MaksymKutyshenko/esp32-gps-tracker/hardware/assembly-sheet.html

# GPS Tracker Wiring

ESP32-S3 SuperMini build · rev 2 · 2026-10-15 · pins match firmware/include/config.hpp

Bench sheet for assembling the tracker on a breadboard. One table per module, read left to right: module pin, wire, where it goes. Wire colours follow the legend so a photo of the board can be checked against this page.

Before the first wire

- 3.3 V logic everywhere. The ESP32-S3 pins are not 5 V tolerant. GNSS modules and the OLED output 3.3 V logic even when fed 5 V, so TX/RX/SDA/SCL go straight in.
- Measure the shield's "3V" rail first. Listings disagree whether it is 3.0 V or 3.3 V. Below 3.1 V, feed the OLED and BMA400 from the board's 3V3 pin instead and give the SD module 5 V (level-shifter type only).
- Never join the SuperMini's 3V3 pin to the shield's 3V rail. Both are regulator outputs. The board makes its own 3.3 V from its 5V pin.
- The SuperMini's 5V pin is its USB power line, with no diode. Feed it from the shield only with the USB cable unplugged. On the bench with the console open, power the board from USB and leave that wire off; keep GND common.
- BIGGA GSM: TX is 5 V logic and the modem draws 2 A bursts. Put 6.8 kΩ from the board's TX pin to GND before it reaches GPIO44. Put C1, a 1000 µF electrolytic, across VSS and GND right at the board's pins, + to VSS: the board's own 100 + 10 + 1 µF are not enough on battery, and without C1 every registration burst resets the ESP32. Use short 22 AWG or thicker wires for VCC/GND.
- PWRKEY through an NPN transistor. Q1 2N2222A at the ESP end: GPIO7 → 10 kΩ → base, 100 kΩ base to GND, emitter to GND, collector to PK. A bare wire from the modem's PK pin carried the disturbance of every network attach into the chip and reset it with the task watchdog. Find the transistor's pins with the meter's diode test first. Without a transistor: 1 kΩ in series with 100 nF to GND and gsmPowerKeyViaTransistor = false, or PK tied to GND and gsmPowerKeyWired = false.
- One ground. Every GND goes to the shield's GND. Star it at the shield, not daisy-chained through modules.
- Check 18650 polarity twice before inserting. A reversed cell burns the shield's protection IC.
- Antennas. GNSS patch antenna face-up with a sky view; keep the GSM antenna cable away from it.

## Rails and wire colours

Four rails come off the battery shield. Everything in the tables below is tagged with one of them or with a signal name.

+5V red +3V3 orange GND black B+ (cell) purple signals: TX yellow · RX green · SDA blue · SCL white · SPI grey · control brown

flowchart LR
  CELLS["2 x 18650 HG2"] --> SHIELD["Battery Shield V8
boost + protection"]
  SHIELD -- "+5V ≤ 2.2 A, USB unplugged" --> DEV["SuperMini 5V pin
(onboard LDO → 3V3_BOARD)"]
  SHIELD -- "+5V" --> GNSS["GNSS module VCC"]
  SHIELD -- "+5V, short thick wires" --> GSM["BIGGA GSM VCC"]
  SHIELD -- "+3V3 1 A" --> OLED["SSD1306 VCC"]
  SHIELD -- "+5V" --> SD["MicroSD adapter VCC
(onboard 3.3 V regulator + shifter)"]
  SHIELD -- "+3V3" --> ACC["BMA400 VCC, button module VCC"]
  SHIELD -- "B+ (cell)" --> DIV["100k / 100k divider → GPIO1"]
  SHIELD -- "GND star" --> ALL["every module GND"]

## Wiring diagram

Every wire on the bench, drawn once. Each module's subtitle names the bus it talks on (UART, I2C, SPI, ADC, interrupt) with its speed or address, and the tags inside the board mark which peripheral each pin group belongs to. The board's pins are in logical order here (grouped by module), not in header order; the pin map below gives the physical positions. Power rails run down both sides from the shield.

## ESP32-S3 SuperMini pin map

The SuperMini is the hub. Every signal wire ends here; the table is the same assignment as config.hpp and the schematic.

Board pin | Direction | Signal | Goes to
5V | ← | +5V | Battery shield 5V, only with USB unplugged (the pin is USB VBUS)
GND | — | GND | Battery shield GND (star)
3V3 | out | 3V3_BOARD | Leave free. Do not tie to the shield rail.
GPIO1 | ← | BATT_SENSE | Divider midpoint (R1/R2)
GPIO2 | ← | BTN | Button module SIG (the module has its own pull-down)
GPIO5 | ← | GNSS_TXD | GNSS TX
GPIO4 | → | GNSS_RXD | GNSS RX
GPIO6 | ← | ACC_INT1 | BMA400 INT1
GPIO7 | → | GSM_PWRKEY | R5 10 kΩ to Q1's base (R6 100 kΩ base to GND); Q1's collector to BIGGA PK. High = key pressed
GPIO8 | ↔ | SDA | OLED SDA, BMA400 SDA, GNSS compass SDA
GPIO9 | → | SCL | OLED SCL, BMA400 SCL, GNSS compass SCL
GPIO10 | → | SD_CS | MicroSD CS
GPIO11 | → | SD_SCK | MicroSD SCK (CLK)
GPIO12 | → | SD_MOSI | MicroSD MOSI (DI)
GPIO13 | ← | SD_MISO | MicroSD MISO (DO)
GPIO43 (TX) | → | GSM_RXD | BIGGA RX
GPIO44 (RX) | ← | GSM_TXD | BIGGA TX, with 6.8 kΩ from that pin to GND
USB-C port | — | console | Laptop, USB Serial/JTAG: log + commands, flashing

Keep off: GPIO0 (BOOT), GPIO3, GPIO19/20 (USB), GPIO45/46. The onboard RGB LED on GPIO48 is the status light; nothing to wire. DevKitC-1 build (pio run -e devkitc): the same pins, except the modem on GPIO17/18 and the console on the "UART" connector.

## Module by module

### Battery Shield V8 with 2×18650

J5 · source of every rail

Cells in parallel. Charge through the shield's own USB port. Expect a 0.5 s dropout when the charger is plugged in; the firmware keeps state in NVS so that is harmless.

Shield pin | | Rail | Feeds
5V | → | +5V | SuperMini 5V (USB unplugged), GNSS VCC, BIGGA GSM VSS, MicroSD VCC
3V | → | +3V3 | OLED VCC, BMA400 VCC and CS, button module VCC. Measure first.
GND | — | GND | Star point for every module, the board, capacitors −, divider, button module
B+ (cell terminal) | → | +BATT | R1 top only (battery divider)

### GNSS: Foxeer M10Q-250 (or Beitian BE-220)

J1 · UART1

Foxeer has six pads; the BE-220 only the first four. TX and RX cross: the module's TX goes to the ESP's RX pin. Baud: Foxeer 115200 (default profile), BE-220 9600 (set gnss 1, save).

Module pin | | Net | Connect to
VCC / 5V | ← | +5V | Shield 5V
GND | — | GND | Shield GND
TX | → | GNSS_TXD | SuperMini GPIO5
RX | ← | GNSS_RXD | SuperMini GPIO4
SCL (Foxeer compass) | ← | SCL | SuperMini GPIO9 (optional)
SDA (Foxeer compass) | ↔ | SDA | SuperMini GPIO8 (optional)

### SSD1306 0.96" OLED

J3 · I2C 0x3C

The module carries its own pull-ups. Bus runs at 100 kHz, so breadboard wires are fine.

Module pin | | Net | Connect to
GND | — | GND | Shield GND
VCC | ← | +3V3 | Shield 3V (or the board's 3V3 if the rail measures 3.0 V)
SCL | ← | SCL | SuperMini GPIO9
SDA | ↔ | SDA | SuperMini GPIO8

### MicroSD SPI module

J4 · SPI2

Pins run in a straight row on the board: CS 10, SCK 11, MOSI 12, MISO 13. This adapter (6 pins, rated 4.5–5.5 V) is the 5 V kind: it has its own 3.3 V regulator and a level-shifter chip, so VCC goes to a shield 5V pin and the four signals go directly to the board at 3.3 V. On 3.3 V it stays silent and the firmware reports a mount timeout. Card: 8–32 GB, FAT32.

Module pin | | Net | Connect to
GND | — | GND | Shield GND
VCC | ← | +5V | Shield 5V (module regulates to 3.3 V internally)
MISO (DO) | → | SD_MISO | SuperMini GPIO13
MOSI (DI) | ← | SD_MOSI | SuperMini GPIO12
SCK (CLK) | ← | SD_SCK | SuperMini GPIO11
CS | ← | SD_CS | SuperMini GPIO10

### BIGGA GSM (SIM800C) board

J2 · UART2 · C1 1000 µF on VSS · R3 6.8 kΩ on TX · Q1 NPN on PK · LED1 + 1 kΩ on NET

Silkscreen names on the board: NET VSS PK RX TX GND on one edge, SPN SPP MICN MICP RING DTR on the other. VSS is the 5 V supply input here, not ground; confirm with the meter that the pin marked GND beeps against the SMA shell and VSS does not. TX idles at 5 V: the board's level shifter is referenced to VCC, so a 6.8 kΩ resistor from TX to GND is required before GPIO44 (gives about 3.0 V). RX needs nothing extra. BOOT is the modem's PWRKEY; the board does not start by itself, the firmware holds BOOT low for a second when the modem is silent, through the transistor Q1 at the ESP end. Feed VCC with 5 V only: 9 V damages the ESP through the shifter, 3.3 V is below the regulator's dropout. Nano-SIM, PIN disabled, 2G coverage confirmed, full-size SMA antenna.

Board pin | | Net | Connect to
GND | — | GND | Shield GND, short thick wire
TX | → | GSM_TXD | R3 6.8 kΩ from this pin to GND, then the pin to SuperMini GPIO44
RX | ← | GSM_RXD | SuperMini GPIO43 directly
PK (= BOOT / PWRKEY) | ← | GSM_PWRKEY | Q1 collector; Q1 emitter to GND, base through R5 10 kΩ to SuperMini GPIO7, R6 100 kΩ base to GND
VSS (= VCC, 5 V in) | ← | +5V | Shield 5V, short thick wire, and C1 1000 µF electrolytic across VSS and GND right at the board's pins (+ to VSS); the onboard 100+10+1 µF are not enough on battery
NET | → | LED1 | NET → 1 kΩ → red LED anode; LED cathode → GND. Blink: 0.8 s = searching, 3 s = registered, 0.3 s = GPRS data. 2.8 V signal, dim but visible; no GPIO
DTR, RING, SPN, SPP, MICN, MICP | — | n/c | Leave open
Antenna | — | SMA | GSM SMA antenna, cable routed away from the GNSS patch

### Button module

J7 · 3 pins

A module with VCC, GND and a signal pin. Its own pull-down holds SIG low at rest; a press connects it to VCC, so buttonPressedHigh = true in config.hpp. A bare switch to GND works too, with that setting false. Short press = next display page, hold ≥ 1 s = print diagnostics; also a deep-sleep wake source.

Module pin | | Connect to
VCC | ← | +3V3 shield 3V
GND | — | GND
SIG | → | SuperMini GPIO2 BTN

### Battery sense divider

R1, R2 · 100 kΩ each

Halves the cell voltage so 4.2 V becomes 2.1 V at the ADC. 100 k keeps the drain at about 20 µA.

Part | | Connect to
R1 end A | ← | +BATT shield B+
R1 end B + R2 end A | → | SuperMini GPIO1 BATT_SENSE
R2 end B | — | GND

### BMA400 (CJMCU-400)

J6 · I2C 0x14 · INT1 → GPIO6 · CS → 3V3

Shares the I2C bus with the OLED. INT1 lands on an RTC-capable pin: it wakes the chip from deep sleep. Tie CS to 3V3: the chip picks I2C or SPI from that pin at power-up, and left to the board's pull-up it came up in SPI mode on one boot in three, silent on the bus. SDO sets the address (low 0x14, high 0x15); the firmware probes both, so tying it to GND is optional but makes the boot log predictable. INT2 stays unconnected.

Module pin | | Net | Connect to
VCC | ← | +3V3 | Shield 3V (3.3 V only; never 5 V)
GND | — | GND | Shield GND
SDA | ↔ | SDA | SuperMini GPIO8
SCL | ← | SCL | SuperMini GPIO9
INT1 | → | ACC_INT1 | SuperMini GPIO6
CS | ← | +3V3 | Shield 3V, same rail as VCC (I2C mode at power-up)
SDO | ← | GND | Optional: fixes the address at 0x14
INT2 | — | n/c | Leave open

## Assembly order with checks

Add one module at a time and watch the console after each. The expected log line comes from the firmware; if it does not appear, stop and fix that module before adding the next. Ticks are remembered in this browser only.

1. Shield: insert cells (polarity!), switch on, measure 5V and 3V rails with the multimeter. Write the 3V figure here: ______ V.5V rail: 4.9–5.2 V · 3V rail: 3.0 or 3.3 V (decides OLED/SD supply)
2. SuperMini alone: USB-C to the laptop, GND to the shield, flash with pio run -e supermini -t upload -t monitor. If the port does not appear, hold BOOT while plugging in.I (..) tracker: Boot: reset reason power-on (1) I (..) console: Commands on USB Serial/JTAG; type 'help' LED white, then amber once the GNSS is added
3. Button module (VCC 3V3, GND, SIG→GPIO2) and the battery divider on GPIO1.a press logs "Button: short press, next page"; diag → battery error counter stays 0; the system page shows the cell voltage
4. GNSS: 5V, GND, TX→GPIO5, RX→GPIO4. Put the antenna by a window or outside.I (..) tracker: State BOOTING -> ACQUIRING I (..) tracker: State ACQUIRING -> TRACKING (sky view, 30–90 s cold) Wrong baud: 'rej' grows in diag → set gnss 1 / save
5. OLED: GND, VCC, SCL→GPIO9, SDA→GPIO8.I (..) ssd1306: Display ready at address 0x3C Tracking page with state, satellites, position
6. MicroSD: GND, VCC→shield 5V (not 3V), CS→GPIO10, SCK→GPIO11, MOSI→GPIO12, MISO→GPIO13 (a straight run). Card formatted FAT32.I (..) sdcard: Mounted /sdcard: NNNN MiB 'SD ok' on the screen; TRACKS/YYYYMMDD.CSV appears after the first record
7. BIGGA GSM: 6.8 kΩ from TX to GND, LED + 1 kΩ on NET, C1 1000 µF across VSS/GND at the board (+ to VSS), Q1 with R5 10 kΩ and R6 100 kΩ for PK at the ESP end, then VCC/GND with short thick wires, TX→GPIO44, RX→GPIO43, PK→Q1 collector (base via R5 from GPIO7), VSS→5V (it is the supply, not ground), antenna. Measure TX idle at GPIO44 with the modem on: expect about 3.0 V, not 5 V. NET LED: fast blink while searching, one blink every 3 s once registered. Console: set apn <your apn>, set url ..., set id ..., set uplink 1, save.I (..) sim800: Modem silent at every baud rate, pulsing PWRKEY (1/3) (normal: the board needs the pulse) I (..) sim800: Modem answered at 9600 baud (or 115200) I (..) uplink: GPRS up on APN internet 'sent:' grows on the system page; the point appears in Traccar
8. Soak: leave it running 10 minutes, then diag. Note the counters and stack headroom for the README.nmea rx N rej 0 silences 0 | log ok N drop 0 err 0 | up ok N ... | stack free: gps … display … logger … uplink … ui …

Sources in the repository: hardware/README.md (power tree, GPIO map), hardware/kicad/gps_tracker.kicad_sch (schematic, ERC clean), firmware/include/config.hpp (the pin constants the firmware uses). Module pin orders on the breakout boards vary by vendor; the tables name pins by function, so follow the silkscreen.
