MaksymKutyshenko/esp32-gps-tracker/hardware/kicad/gps_tracker.pdf

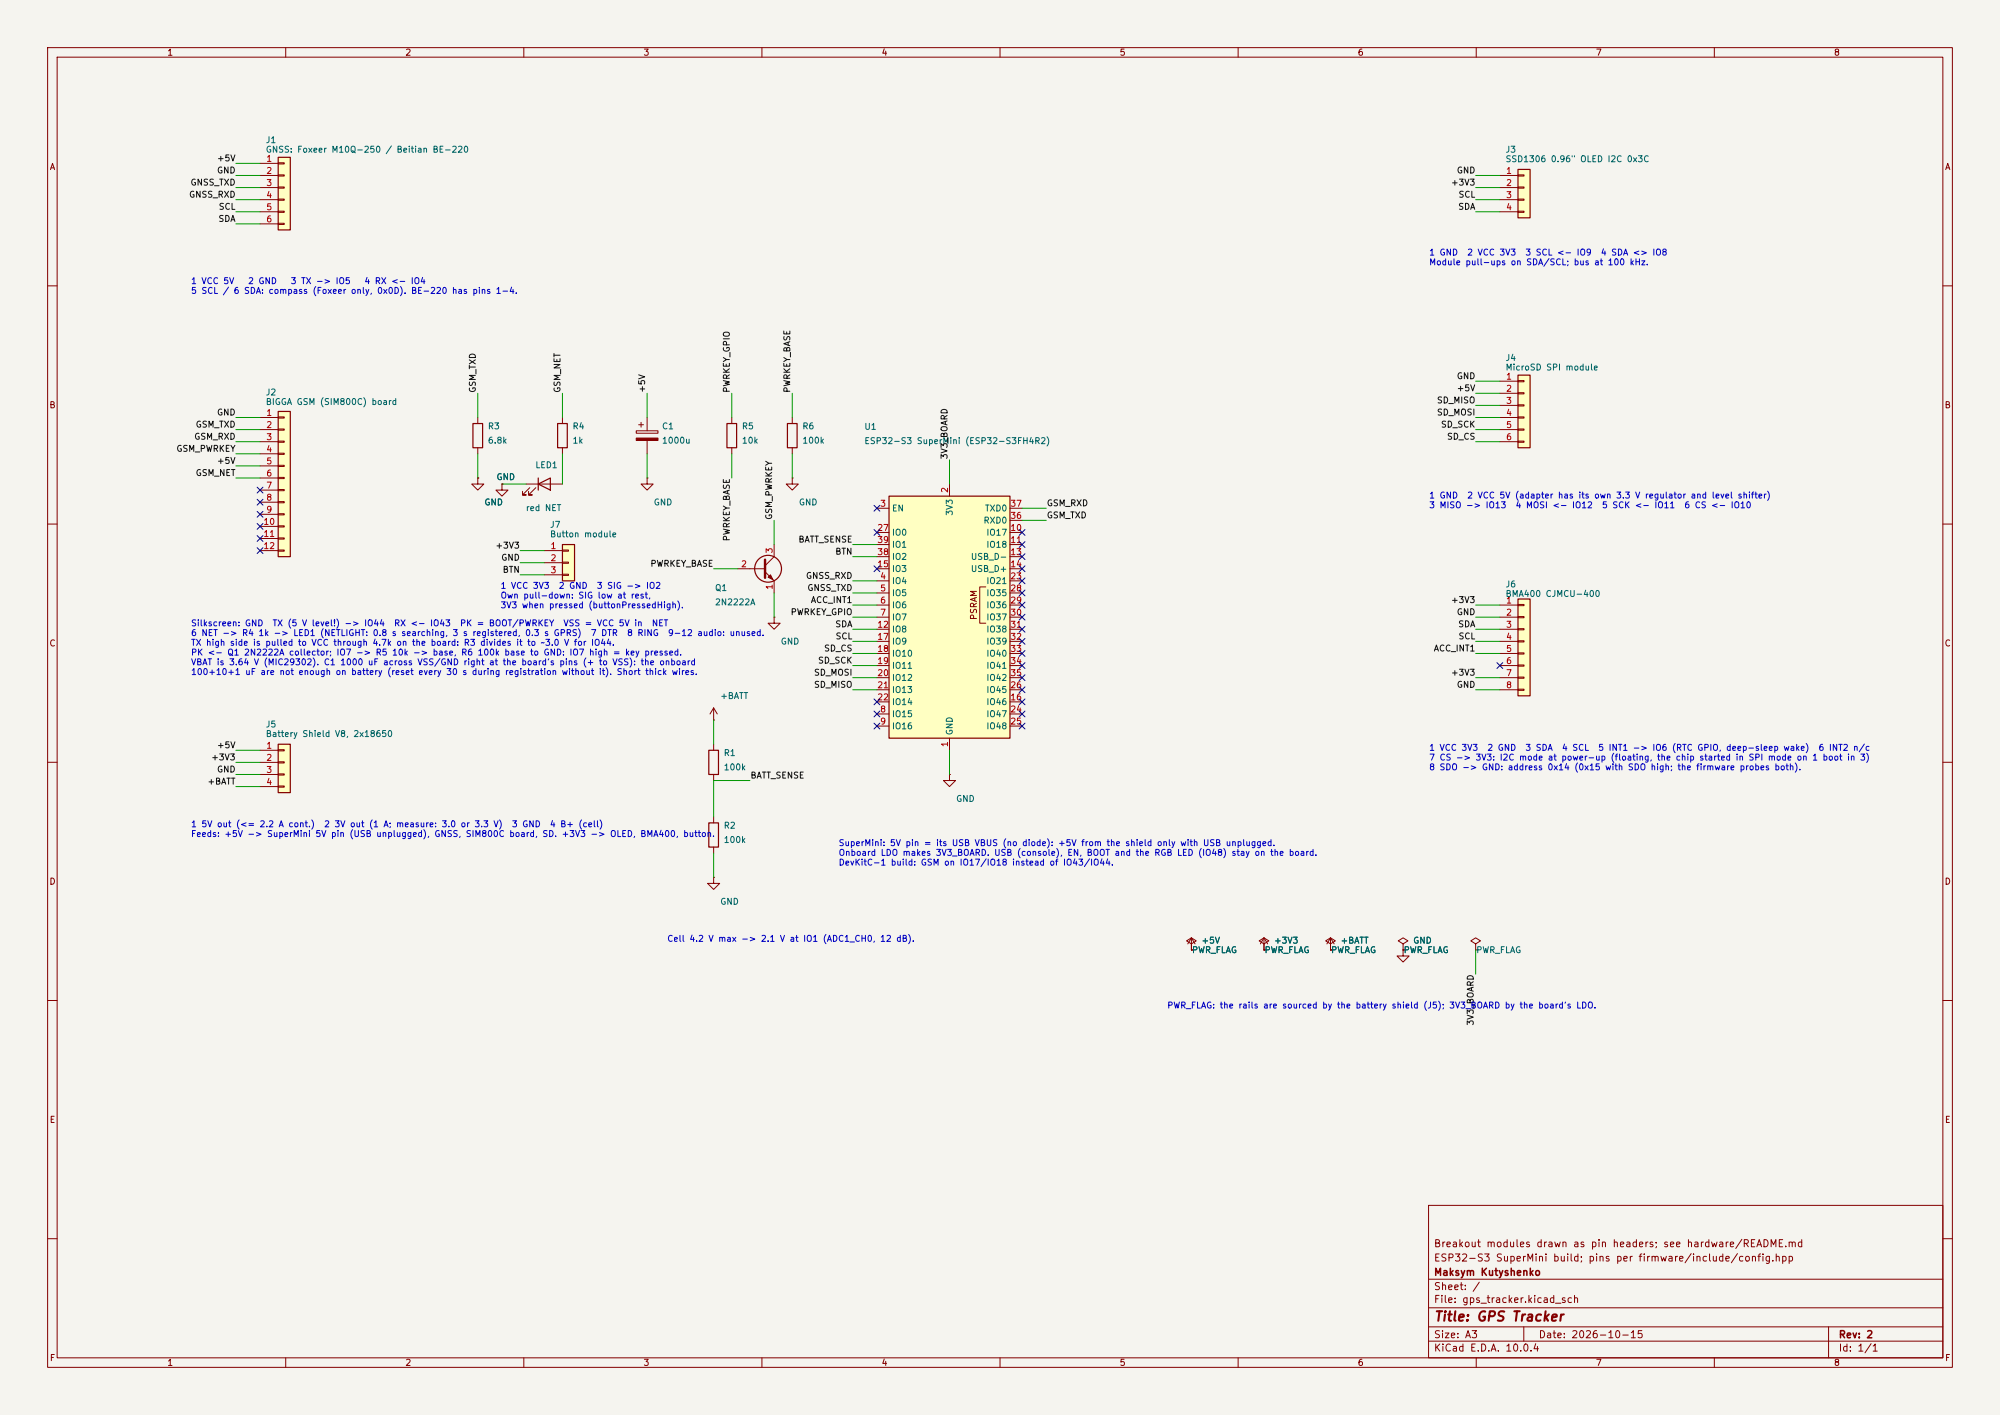
[picture p1: page 1]

5 SCL / 6 SDA: compass (Foxeer only, 0x0D). BE-220 has pins 1-4.

Silkscreen: GND TX (5 V level!) -> IO44 RX <- IO43 PK = BOOT/PWRKEY VSS = VCC 5V in NET 6 NET -> R4 1k -> LED1 (NETLIGHT: 0.8 s searching, 3 s registered, 0.3 s GPRS) 7 DTR 8 RING 9-12 audio: unused. TX high side is pulled to VCC through 4.7k on the board: R3 divides it to ~3.0 V for IO44. PK <- Q1 2N2222A collector; IO7 -> R5 10k -> base, R6 100k base to GND: IO7 high = key pressed. VBAT is 3.64 V (MIC29302). C1 1000 uF across VSS/GND right at the board's pins (+ to VSS): the onboard 100+10+1 uF are not enough on battery (reset every 30 s during registration without it). Short thick wires. Cell 4.2 V max -> 2.1 V at IO1 (ADC1_CH0, 12 dB).

Breakout modules drawn as pin headers; see hardware/README.md
ESP32-S3 SuperMini build; pins per firmware/include/config.hpp
Maksym Kutyshenko
Sheet: /
File: gps_tracker.kicad_sch
Title: GPS Tracker

Size: A3 | Rev: 2 | F Date: 2026-10-15
KiCad E.D.A. 10.0.4 | Id: 1/1
