MaksymKutyshenko/esp32-gps-tracker/docs/kicad/gps_tracker.pdf

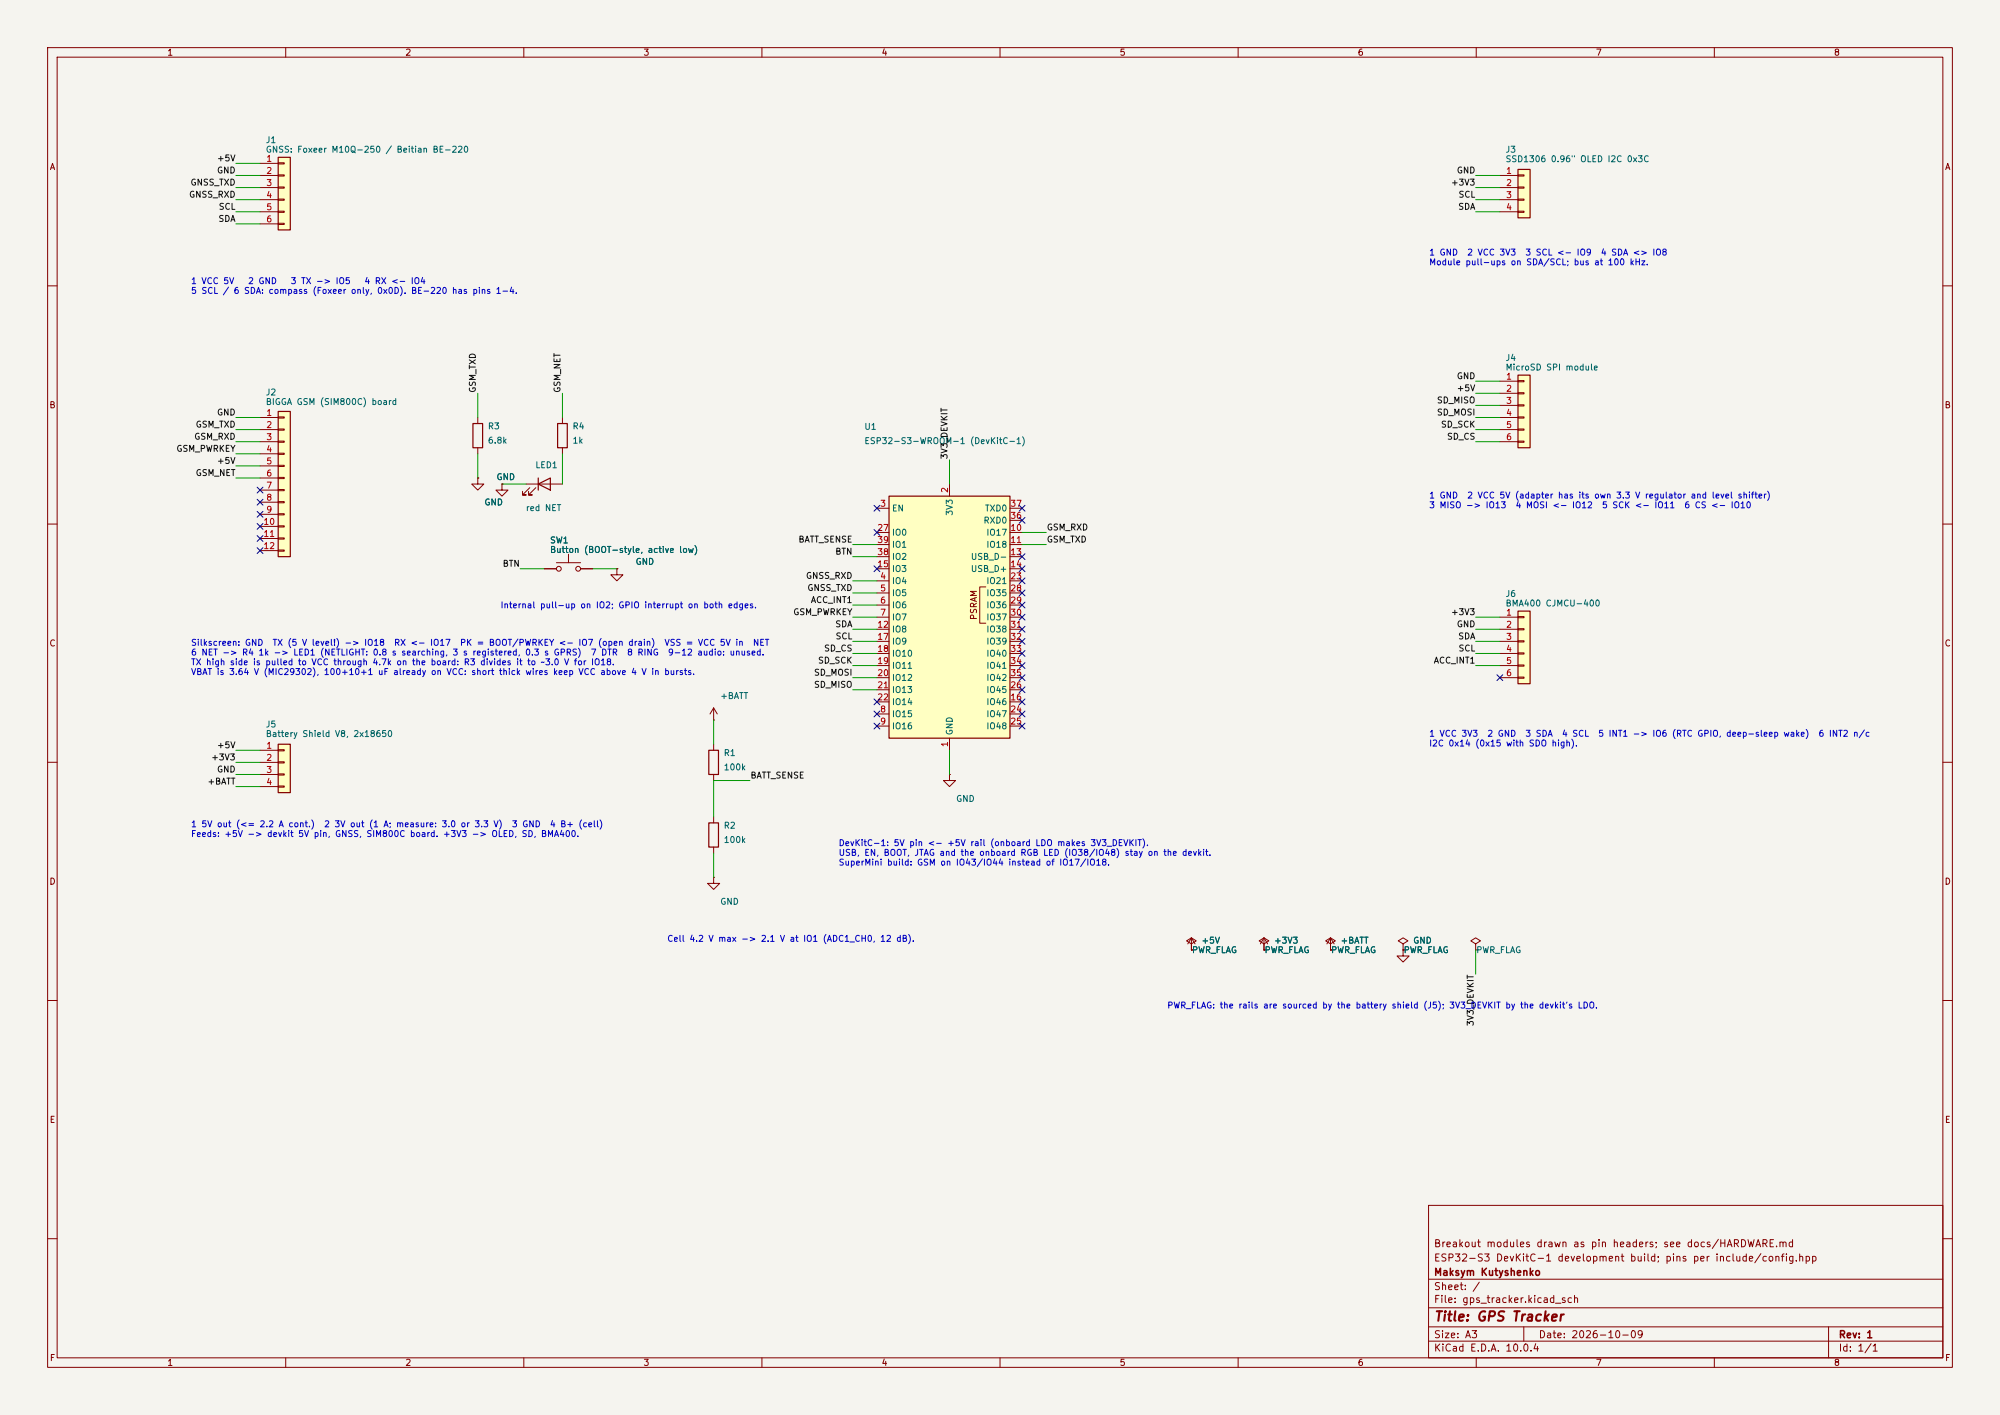
[picture p2: page 1]

5 SCL / 6 SDA: compass (Foxeer only, 0x0D). BE-220 has pins 1-4. Silkscreen: GND TX (5 V level!) -> IO18 RX <- IO17 PK = BOOT/PWRKEY <- IO7 (open drain) VSS = VCC 5V in NET 6 NET -> R4 1k -> LED1 (NETLIGHT: 0.8 s searching, 3 s registered, 0.3 s GPRS) 7 DTR 8 RING 9-12 audio: unused. TX high side is pulled to VCC through 4.7k on the board: R3 divides it to ~3.0 V for IO18. VBAT is 3.64 V (MIC29302), 100+10+1 uF already on VCC: short thick wires keep VCC above 4 V in bursts.

SW1 Button (BOOT-style, active low) GND

Breakout modules drawn as pin headers; see docs/HARDWARE.md PSRAM GND

PWR_FLAG: the rails are sourced by the battery shield (J5); 3V3_DEVKIT by the devkit's LDO.

ESP32-S3 DevKitC-1 development build; pins per include/config.hpp
Maksym Kutyshenko
Sheet: /
File: gps_tracker.kicad_sch
Title: GPS Tracker

Size: A3 | Rev: 1
KiCad E.D.A. 10.0.4 | Id: 1/1 | F Date: 2026-10-09
