MaksymKutyshenko/esp32-gps-tracker/hardware/kicad/gps_tracker.kicad_sch

## KiCad design hardware/kicad/gps_tracker.kicad_sch (2026-10-15)

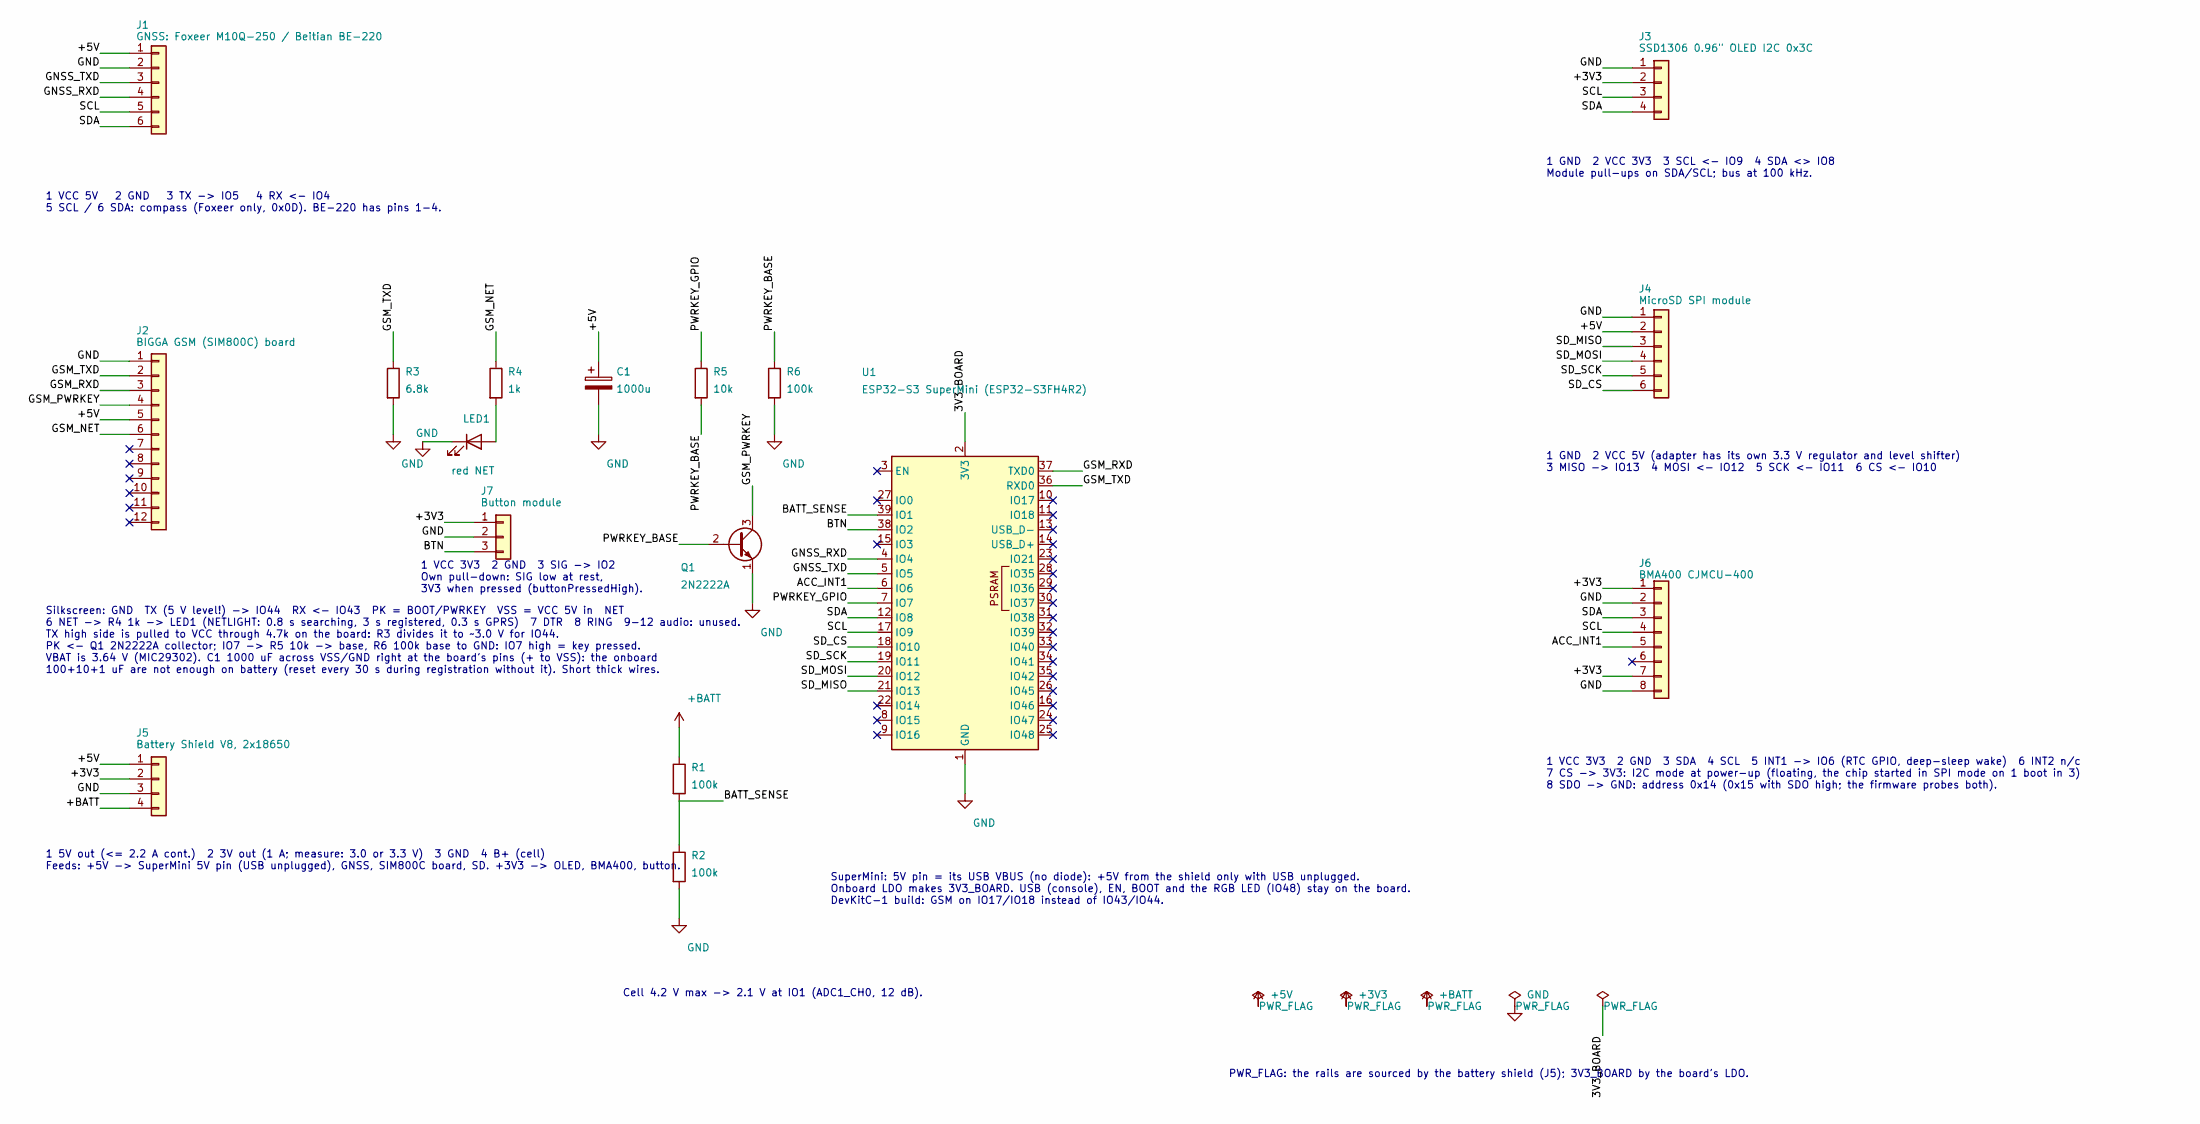
[picture p3: schematic gps_tracker.kicad_sch]

Parts:
C1: 1000u
J1: GNSS: Foxeer M10Q-250 / Beitian BE-220
J2: BIGGA GSM (SIM800C) board
J3: SSD1306 0.96" OLED I2C 0x3C
J4: MicroSD SPI module
J5: Battery Shield V8, 2x18650
J6: BMA400 CJMCU-400
J7: Button module
LED1: red NET
Q1: 2N2222A
R1, R2, R6: 100k
R3: 6.8k
R4: 1k
R5: 10k
U1: ESP32-S3 SuperMini (ESP32-S3FH4R2)

Connections:
3V3_BOARD: U1.2 (3V3)
+3V3: J3.2, J5.2, J6.1, J6.7, J7.1
+5V: C1.1, J1.1, J2.5, J4.2, J5.1
+BATT: J5.4, R1.1
ACC_INT1: J6.5, U1.6 (IO6)
BATT_SENSE: R1.2, R2.1, U1.39 (IO1)
BTN: J7.3, U1.38 (IO2)
GND: C1.2, J1.2, J2.1, J3.1, J4.1, J5.3, J6.2, J6.8, J7.2, LED1.1 (K), Q1.1 (E), R2.2, R3.2, R6.2, U1.1 (GND), U1.40 (GND), U1.41 (GND)
GNSS_RXD: J1.4, U1.4 (IO4)
GNSS_TXD: J1.3, U1.5 (IO5)
GSM_NET: J2.6, R4.1
GSM_PWRKEY: J2.4, Q1.3 (C)
GSM_RXD: J2.3, U1.37 (TXD0)
GSM_TXD: J2.2, R3.1, U1.36 (RXD0)
unnamed: LED1.2 (A), R4.2
PWRKEY_BASE: Q1.2 (B), R5.2, R6.1
PWRKEY_GPIO: R5.1, U1.7 (IO7)
SCL: J1.5, J3.3, J6.4, U1.17 (IO9)
SDA: J1.6, J3.4, J6.3, U1.12 (IO8)
SD_CS: J4.6, U1.18 (IO10)
SD_MISO: J4.3, U1.21 (IO13)
SD_MOSI: J4.4, U1.20 (IO12)
SD_SCK: J4.5, U1.19 (IO11)

Notes on the sheet:
SuperMini: 5V pin = its USB VBUS (no diode): +5V from the shield only with USB unplugged. Onboard LDO makes 3V3_BOARD. USB (console), EN, BOOT and the RGB LED (IO48) stay on the board. DevKitC-1 build: GSM on IO17/IO18 instead of IO43/IO44.
1 VCC 5V 2 GND 3 TX -> IO5 4 RX <- IO4 5 SCL / 6 SDA: compass (Foxeer only, 0x0D). BE-220 has pins 1-4.
Silkscreen: GND TX (5 V level!) -> IO44 RX <- IO43 PK = BOOT/PWRKEY VSS = VCC 5V in NET 6 NET -> R4 1k -> LED1 (NETLIGHT: 0.8 s searching, 3 s registered, 0.3 s GPRS) 7 DTR 8 RING 9-12 audio: unused. TX high side is pulled to VCC through 4.7k on the board: R3 divides it to ~3.0 V for IO44. PK <- Q1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
1 GND 2 VCC 3V3 3 SCL <- IO9 4 SDA <> IO8 Module pull-ups on SDA/SCL; bus at 100 kHz.
1 GND 2 VCC 5V (adapter has its own 3.3 V regulator and level shifter) 3 MISO -> IO13 4 MOSI <- IO12 5 SCK <- IO11 6 CS <- IO10
1 VCC 3V3 2 GND 3 SDA 4 SCL 5 INT1 -> IO6 (RTC GPIO, deep-sleep wake) 6 INT2 n/c 7 CS -> 3V3: I2C mode at power-up (floating, the chip started in SPI mode on 1 boot in 3) 8 SDO -> GND: address 0x14 (0x15 with SDO high; the firmware probes both).
1 5V out (<= 2.2 A cont.) 2 3V out (1 A; measure: 3.0 or 3.3 V) 3 GND 4 B+ (cell) Feeds: +5V -> SuperMini 5V pin (USB unplugged), GNSS, SIM800C board, SD. +3V3 -> OLED, BMA400, button.
Cell 4.2 V max -> 2.1 V at IO1 (ADC1_CH0, 12 dB).
1 VCC 3V3 2 GND 3 SIG -> IO2 Own pull-down: SIG low at rest, 3V3 when pressed (buttonPressedHigh).
PWR_FLAG: the rails are sourced by the battery shield (J5); 3V3_BOARD by the board's LDO.
