MaksymKutyshenko/esp32-gps-tracker/include/logic/SleepPolicy.hpp

#pragma once

#include <stdint.h>

#include "logic/TrackerFsm.hpp"

// When a parked tracker may go to deep sleep: after afterStationaryMs in
// the Stationary state, and only once the uplink has nothing left to send,
// so the last heartbeat and the "sleeping" health report are not lost.
// Any other state ends the parked period; 0 disables sleep altogether.
//
// Pure logic, no ESP-IDF dependency; unit-tested on the host.
class SleepPolicy
{
public:
    struct Params
    {
        uint32_t afterStationaryMs;
    };

    explicit SleepPolicy(const Params &params) : params_(params) {}

    void setParams(const Params &params) { params_ = params; }

    // Called on every FSM transition with the new state.
    void onState(TrackerState state, uint32_t nowMs)
    {
        if (state != TrackerState::Stationary)
        {
            parked_ = false;
            return;
        }
        if (!parked_)
        {
            parked_ = true;
            parkedSinceMs_ = nowMs;
        }
    }

    bool due(uint32_t nowMs, bool uplinkIdle) const
    {
        if (params_.afterStationaryMs == 0 || !parked_ || !uplinkIdle)
        {
            return false;
        }
        // The epoch's timestamp can be a few ms older than the one the
        // transition was stamped with (it is taken before the FSM runs), so
        // an unsigned difference would wrap to "parked for 49 days". A
        // signed difference reads that as "not yet".
        const int32_t parkedForMs = static_cast<int32_t>(nowMs - parkedSinceMs_);
        return parkedForMs >= static_cast<int32_t>(params_.afterStationaryMs);
    }

private:
    Params params_;
    bool parked_ = false;
    uint32_t parkedSinceMs_ = 0;
};
