MaksymKutyshenko/esp32-gps-tracker/src/periph/Button.cpp

#include "periph/Button.hpp"

#include "esp_attr.h"
#include "esp_timer.h"

Button::Button(gpio_num_t pin) : pin_(pin)
{
}

void Button::begin(QueueHandle_t edgeQueue)
{
    queue_ = edgeQueue;

    gpio_config_t config = {};
    config.pin_bit_mask = 1ULL << pin_;
    config.mode = GPIO_MODE_INPUT;
    config.pull_up_en = GPIO_PULLUP_ENABLE;
    config.pull_down_en = GPIO_PULLDOWN_DISABLE;
    config.intr_type = GPIO_INTR_ANYEDGE;
    ESP_ERROR_CHECK(gpio_config(&config));

    // The ISR service is shared by every GPIO interrupt; a second begin()
    // (another button, the accelerometer's INT pin) finds it installed.
    const esp_err_t installed = gpio_install_isr_service(0);
    if (installed != ESP_ERR_INVALID_STATE)
    {
        ESP_ERROR_CHECK(installed);
    }
    ESP_ERROR_CHECK(gpio_isr_handler_add(pin_, isrEntry, this));
}

bool Button::isPressed() const
{
    return gpio_get_level(pin_) == 0;
}

void IRAM_ATTR Button::isrEntry(void *self)
{
    auto *button = static_cast<Button *>(self);
    ButtonEdge edge = {};
    edge.pressed = gpio_get_level(button->pin_) == 0;
    edge.timestampUs = esp_timer_get_time();

    BaseType_t woken = pdFALSE;
    if (xQueueSendFromISR(button->queue_, &edge, &woken) != pdTRUE)
    {
        button->droppedEdges_.fetch_add(1, std::memory_order_relaxed);
    }
    portYIELD_FROM_ISR(woken);
}
