MaksymKutyshenko/esp32-gps-tracker/(commit log)

2026-10-09 Scaffold GPS tracker project: ESP-IDF skeleton, requirements, native tests
    PlatformIO project for the ESP32-S3 DevKitC-1 on ESP-IDF, following the
    conventions of the course homework repo: App class kept static in
    app_main(), one heartbeat task as the RTOS skeleton, constants in a Config
    namespace, ESP_LOGx only, and a native Unity environment for host-side
    tests of the pure logic.
    REQUIREMENTS.md compiles the course's final-project requirements (LMS
    lessons 59 and 70-74, the 42-item grading checklist with the 80% pass
    rule) and maps each item onto the tracker.
2026-10-09 Add hardware design: component roles, power tree, per-board GPIO map
    docs/HARDWARE.md records the chosen components (ESP32-S3 SuperMini with a
    DevKitC-1 fallback, Foxeer M10Q-250 / Beitian BE-220 GNSS, SIM800C GPRS
    modem, BMA400 motion sensor, SSD1306, MicroSD over SPI, 2x18650 Battery
    Shield V8), the power tree with the 1000 uF reservoir at the modem, and
    the GPIO map. config.hpp carries the same pins, selected per board by
    -DBOARD_SUPERMINI / -DBOARD_DEVKITC from two PlatformIO environments.
    The console moves to USB Serial/JTAG (sdkconfig.defaults): the SuperMini
    has no USB-UART bridge, and it frees GPIO43/44 for the modem UART there.
    sdkconfig.defaults also enables the task watchdog pani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
2026-10-09 config: fixed-width types for baud rates, buffer sizes and the I2C timeout
    TECH_REQUIREMENTS.md allows a bare int only where an ESP-IDF signature
    demands it. The constants now stay uint32_t / size_t and the driver
    wrappers cast at the API call, the way SpiBus already does for
    clock_speed_hz.
2026-10-09 docs: software architecture — layers, tasks, patterns and reliability rules
    Records the design rules for the firmware before any driver is written:
    OOP with one class per file, interfaces for everything a host test fakes,
    Strategy for module/protocol/policy choices, a table-driven State machine
    for the tracker, FreeRTOS queues as the observer mechanism, RAII guards
    for every mutex, Command objects for the modem's AT dialogue, App as the
    composition root and Null Objects for hardware that may be absent. Lists
    the patterns deliberately avoided and the reliability mechanism for each
    failure the checklist asks about.
2026-10-09 Develop on the DevKitC: default env, UART console there, USB Serial/JTAG on the SuperMini only
    devkitc becomes the default PlatformIO environment. Its CP2102 UART console
    survives deep sleep and crashes, so it is the development board; the
    SuperMini is the final form factor. The console setting therefore moves out
    of the shared sdkconfig.defaults into sdkconfig.defaults.supermini, merged
    through SDKCONFIG_DEFAULTS for that environment only.
2026-10-09 Logic layer: NMEA parsing, tracker FSM, filters, log policy, track records
    Hardware-free, header-only classes under include/logic, covered by 43 Unity
    tests that run on the host with pio test -e native:
    - NmeaLineAssembler frames the receiver byte stream into sentences, resyncs
    on a stray '$' and drops oversized lines instead of truncating them.
    - NmeaParser verifies the checksum, splits fields and folds RMC and GGA into
    an integer fixed-point Fix (degrees * 1e7, cm/s, deci-degrees). A sentence
    that fails any field check leaves the previous Fix untouched; failures are
    counted for the diagnostics line.
    - DecimalParser turns NMEA decimal fields into scaled integers without strtod.
    - T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
2026-10-09 Drivers, transport and the five-task App: GNSS, display, SD logging, GPRS uplink, UI
    Periph layer (include/periph, src/periph):
    - UartPort wraps the IDF UART driver; GnssReceiver turns its byte stream
    into NMEA sentences with a chunk buffer that survives sentence
    boundaries; GnssProfile is the Strategy for the Foxeer M10Q-250 (115200)
    and Beitian BE-220 (9600).
    - I2cBus, Ssd1306 and Font5x7 come from module 4.4 unchanged apart from
    include paths and the cast at the I2C timeout.
    - SdCard mounts the MicroSD over SPI2 with DMA and can remount at runtime.
    - Sim800Modem executes AtCommand values with bounded waits, fixes the baud
    rate, opens the GPRS bearer and performs HTTP GET through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
2026-10-09 Serial console for field settings: show, set, save, diag
    A console task reads lines from the log port (UART0 on the DevKitC, USB
    Serial/JTAG on the SuperMini) through ConsoleInput, parses them with the
    host-tested CommandParser and edits a draft of Settings::Values. 'save'
    validates, persists the blob to NVS and publishes it through two
    single-slot queues; the gps and uplink tasks pick the new values up at the
    top of their loops, so logging cadence, motion thresholds and the upload
    pacing change live without any object shared between tasks. APN, server
    URL, device id and the GNSS profile take effect after a restart.
    This is the edit path the grading checklist's 'parameters are
    configurable'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
2026-10-09 Docs: README with diagrams and bring-up guide, presentation plan, checklist status
    README now carries the task/queue block diagram and the FSM diagram as
    Mermaid (rendered by GitHub), the console usage, the track and upload
    formats, the bring-up order per peripheral, and the sections the course's
    README structure asks for (results, known issues, next steps).
    docs/PRESENTATION.md is the slide outline and the live-demo plan in the
    Module 7.3/7.4 structure, with the architectural questions to prepare.
    docs/ARCHITECTURE.md lists the classes as implemented and gains the
    'Adding the BMA400' section: driver, motion-detector implementation and
    the deep-sleep path, all slotting into hooks that alre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
2026-10-09 KiCad schematic generated from the pin map, ERC clean
    tools/gen_schematic.py builds docs/kicad/gps_tracker.kicad_sch from
    KiCad's own symbol libraries: the ESP32-S3-WROOM-1 module (as mounted on
    the DevKitC-1), generic pin headers for each breakout module (GNSS,
    SIM800C board, OLED, MicroSD, BMA400, battery shield), the battery divider,
    the button and the 1000 uF reservoir at the modem. Every connection is a
    net label on a short stub at the pin, so the drawing reads like the GPIO
    map in config.hpp, and a note next to each header spells out its pins.
    Unused module pins carry no-connect flags; PWR_FLAGs mark the rails the
    shield and the devkit LDO drive.
    kicad-cli ERC reports 0 errors and 0 w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
2026-10-09 Schematic: move the battery-divider note clear of the GND symbol
2026-10-09 Modem supply: 100 uF + ceramic at the board input, the 1000 uF becomes a fallback
    The BIGGA SIM800C board carries an 820 uF 6.3 V low-ESR capacitor on the
    modem's own 4 V rail, eight times the datasheet minimum, so the transmit
    bursts are covered on the board. What remains is the 5 V input to the
    board's regulator sagging over wire and contact resistance; 100 uF plus a
    100 nF ceramic at the board's input pins and short thick wires handle
    that. The 1000 uF stays in the drawer unless the boot line ever shows a
    brownout. Hardware doc, schematic (C2 value and note) and exports updated;
    ERC still clean.
2026-10-09 SIM800C: probe candidate baud rates at power-on; docs use the board's pin names
    The vendor page for this SIM800C board (the common 5V/3.3V TTL board with
    Bluetooth and TTS) lists 5V, V_TTL, GND x3, TXD, RXD, PWR, VBAT, DTR, RI,
    VRTC and the audio pins. Listings disagree on whether it ships fixed at
    9600 baud or in autobaud mode, so powerOn() now tries 115200, 9600, 57600
    and 38400 in turn, and only after the modem answers pins it to 115200
    with AT+IPR and switches the UART. The hardware doc, the schematic note
    and the wiring sheet now name the pin PWR (PWRKEY), state that V_TTL is
    the level-shifter reference and that VBAT, DTR, RI, VRTC and audio stay
    unconnected.
2026-10-09 BIGGA GSM board: 5 V TX line divided to 3 V, open-drain PWRKEY, real header pinout
    The BIGGA GSM schematic (arduino.ua, 2018) shows a MOSFET level shifter
    whose high side is pulled up to VCC, so with the required 5 V supply the
    board's TX idles at 5 V, above the ESP32-S3's 3.6 V limit. A 6.8 k
    resistor from TX to GND forms a divider with the board's 4.7 k pull-up and
    brings the high level to about 3.0 V; RX needs nothing because the ESP
    drives it against a 47 k pull-up. The board's BOOT pin is the SIM800C
    PWRKEY with no auto power-on circuit, so the GPIO driving it is now open
    drain and the firmware's existing 'pulse when silent' path is what starts
    the modem. VBAT is regulated to 3.64 V by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
2026-10-09 Schematic: move C2 clear of the BIGGA header labels
2026-10-09 NET indicator LED on the BIGGA board: 1k + red LED on NETLIGHT
    The modem's NETLIGHT output reaches the header as NET; blinking at 0.8 s
    means searching, 3 s registered, 0.3 s GPRS transfer. A red LED through
    1 k to GND makes that visible on the bench with no firmware involved and
    no GPIO spent, which the SuperMini cannot spare. Added to the schematic
    (R4, LED1), the hardware doc and the wiring sheet.
2026-10-09 Bench wiring diagram generator and SVG
    tools/gen_wiring_svg.py draws the assembly view: power rails as vertical
    buses down both sides, the DevKitC-1 in the middle with pins in logical
    order, modules left and right with power pins leaving towards the rails
    and signal pins towards the devkit, so power and signal wires never cross.
    Covers the shield, GNSS, the BIGGA GSM board with C2, R3 and the NET LED,
    the button, the battery divider, OLED, MicroSD and the BMA400 (dashed,
    not fitted). The SVG uses the page's colour tokens so it follows light and
    dark themes; docs/wiring.svg is the committed copy the README embeds.
2026-10-09 BIGGA GSM: no external input capacitor, the board carries 100+10+1 uF at VCC
    The board schematic shows C6/C5/C8 (100 uF, 10 uF, 1 uF) directly at the
    VCC input, which is what the external 100 uF + ceramic was meant to
    provide. Removed C2 from the schematic, the wiring diagram, the hardware
    doc and the assembly sheet; short thick wires from the shield remain the
    requirement, and the 1000 uF stays a brownout fallback only.
2026-10-10 MicroSD: SCK on GPIO11, MOSI on GPIO12 for a straight header run
    Swaps the two signals from SPI2's IOMUX pins (SCK 12, MOSI 11) so the card
    module wires in order CS-SCK-MOSI-MISO on GPIO10-13. Through the GPIO
    matrix the bus is limited to tens of MHz, far above the 10 MHz the card is
    clocked at. Config, hardware doc, schematic, wiring diagram and README
    updated; ERC clean.
2026-10-10 Keep the assembly sheet source in the repo
    docs/assembly-sheet.html is the published bench sheet (wiring diagram,
    per-module tables, assembly order). Kept here so the page can be
    regenerated and republished from the repository.
2026-10-10 Assembly sheet: strip the publish wrapper from the kept source
2026-10-10 BIGGA GSM: use the board's silkscreen names (NET VSS PK RX TX GND)
    The delivered board labels the six wired pins NET, VSS, PK, RX, TX, GND:
    the schematic's header read from the other end, with VSS meaning the 5 V
    supply input (not ground, as the name usually implies) and PK the power
    key. Sheet, wiring diagram, schematic note and hardware doc now show the
    silkscreen names next to the schematic ones, with the VSS warning and a
    continuity check against the SMA shell.
2026-10-10 Wiring diagram: name the bus on every module and pin group
    Module subtitles now state the interface (UART1 NMEA 115200/9600, UART2 AT
    115200, I2C0 100 kHz with addresses, SPI2 10 MHz, GPIO interrupt, ADC1)
    and small tags inside the devkit mark UART1, UART2, I2C0, SPI2, ADC1 and
    the interrupt pins next to their pin groups.
2026-10-10 MicroSD adapter is the 5 V type: VCC on the 5 V rail
    The adapter in use is the six-pin board rated 4.5-5.5 V, with its own
    3.3 V regulator and level shifter. On the 3 V rail it stays silent and the
    firmware logs a mount timeout at boot, which is what was observed. Sheet,
    wiring diagram, schematic, hardware doc, README and the config comment now
    put its VCC on +5V unconditionally.
2026-10-10 Bench helpers: 'mount' console command and a network status dump on bearer failure
    'mount' retries the storage card on demand instead of waiting for the next
    record, which only exists once there is a fix. When the GPRS bearer fails
    to open, ModemTransport now logs AT+CPIN?, AT+CREG?, AT+CGATT?, AT+CSQ and
    AT+COPS? so the log says whether the SIM is locked, the network refused
    registration, or the APN is wrong, instead of a bare ESP_FAIL.
2026-10-10 Show satellites in view next to satellites used
    NmeaParser folds the GSV sentences' satellites-in-view count (largest
    across the constellation talkers between two RMCs) into the Fix, and the
    tracking page shows used/heard, e.g. 0/9. During bring-up that separates
    'antenna hears satellites, no fix yet' from 'antenna hears nothing'.
2026-10-10 Settings apply live in the uplink task; note the operator menu as a next step
    The uplink task keeps its own copy of Settings::Values, refreshed from the
    console through its queue in both the connect phase and the main loop.
    A changed APN is handed to the transport, which re-opens the bearer on
    the new name without a power cycle; URL and device id are taken from the
    live copy when the report URL is built. Only the GNSS profile still needs
    a restart. README lists the button-driven operator menu as the next UI step.
2026-10-10 Monitor echoes typed console input
    The board does not echo characters, so the PlatformIO monitor showed a
    blank line while typing commands. monitor_echo = yes makes the typed
    line visible.
2026-10-10 Console 'at' passthrough, modem mutex, CEER and bearer status in the dump
    'at <command>' sends a raw AT command to the modem and prints its reply,
    so bench diagnosis (bearer status, PDP rejection cause, manual bearer
    open) no longer needs a rebuild. The modem gets a mutex: the uplink task
    holds it per transaction (connect, HTTP request, reset, CSQ) and the
    console borrows it for one command, waiting in watchdog-fed slices. The
    failure dump now also asks AT+CEER (last rejection cause) and
    AT+SAPBR=2,1 (bearer state).
2026-10-10 Modem: reuse or wait for an existing bearer before opening a new one
    AT+SAPBR=1,1 answers ERROR at once while a bearer is open or still
    opening, and the SIM800C keeps that state across an ESP32 reset. openBearer
    now queries AT+SAPBR=2,1 first: an open bearer is reused, a connecting or
    closing one is waited for (up to 30 s), a stuck one is closed, and only a
    closed bearer gets the APN set and a new open. The result is confirmed by
    polling the status instead of trusting the OK.
2026-10-10 Monitor decodes ESP32 backtraces (task watchdog panics name the task and the frame)
2026-10-10 Display shows the card state before the first fix
    The logger task sent its storage-health message to the display only after
    writing a record, and records need a valid fix. Until then the status strip
    showed 'SD:--' although the card had mounted at boot. The logger now
    publishes the card state when it starts, whenever readiness changes while
    idle, and after every record; the console 'mount' command publishes it too.
2026-10-10 Configure the GNSS receiver at boot: 1 Hz, RMC/GGA/GSV only
    The Foxeer M10Q-250 ships at 10 Hz with GLL, VTG and GSA enabled: 120
    sentences a second, about three quarters of the UART's capacity, and
    every one of them parsed by the highest-priority task. A tracker that
    records every few seconds needs 1 Hz and three sentence types.
    GnssProfile now carries a setup sequence per module, sent by
    GnssReceiver::begin right after the baud rate is set: one UBX-CFG-VALSET
    frame for the M10 (RAM layer, so a power cycle restores the module's own
    configuration) and legacy CFG-RATE/CFG-MSG frames for the M8-class
    BE-220. UbxFrame builds the frames with their Fletcher checksum at
    compile time; the host tes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
2026-10-10 NMEA: accept RMC without time or date while the fix is invalid
    A cold receiver sends RMC with empty time and date fields until it has
    decoded time from a satellite. The parser treated those as field
    failures, so a board waiting for its first satellite counted one rejected
    sentence per second (44 of 371 in a bench minute) and the diagnostics
    could not be told apart from real corruption. Empty time and date are now
    accepted while the status is V; with status A both stay mandatory.
2026-10-10 Show tracked satellites and strongest C/N0; parse 21-field GSV
    The screen's second satellite number was the GSV 'in view' count, which
    on a u-blox receiver includes satellites the almanac predicts above the
    horizon but that are not received at all. '0/11' therefore could not
    tell an antenna with no signal from a receiver still decoding. The
    parser now counts the satellites that carry a C/N0 and keeps the
    strongest value per epoch; the tracking page shows used/tracked and the
    system page adds 'sky N sig M cn0 X'.
    NMEA 4.11 GSV sentences with four satellites carry 21 fields (the signal
    id trails the groups), one more than the parser's field limit, so every
    full GSV from the M10 was rejected a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
2026-10-10 Diagnostics line reports sky/sig/cn0 next to the NMEA counters
    The satellite signal numbers were on the system page only; the
    per-minute diagnostics line now carries them too, so a pasted log is
    enough to tell a dead antenna from a weak spot.
2026-10-10 Defaults sized for a car: record every second moving, upload every 5 s
    The moving interval was 5 s with a 20 m distance trigger, which in
    practice already produced one record per second in a car but read as
    'every 5 s' in the configuration. The defaults now say what happens:
    movingIntervalMs = 1000 (every receiver epoch at 1 Hz), stationary
    heartbeat unchanged at 60 s, uplinkMinIntervalMs = 5000 (close to what
    one HTTP request per upload over 2G can sustain). Comments explain the
    resulting rates.
    Settings::layoutVersion is bumped to 2 so a board with the previous
    defaults saved in NVS takes the new ones instead of keeping the old.
2026-10-10 Enable the receiver's static hold: speed 0 and frozen position when parked
    A receiver with a marginal fix reports 1-3 km/h and a position that
    drifts a few metres a second while the device sits still. On the screen
    that reads as movement, and the motion detector, which parks only after
    30 s below 1.8 km/h, would keep the tracker in TRACKING and writing one
    record a second in a car park.
    u-blox static hold handles this in the receiver: below 1 m/s it reports
    speed 0 and holds the position until it moves 20 m or the speed rises.
    The setup sequence now enables it, as a second CFG-VALSET frame on the
    M10 (so an unknown key cannot reject the rate frame) and as CFG-NAV5
    with only the staticHold m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
2026-10-10 Uplink: size the URL and AT command buffers so no report is refused as too long
    Every upload failed with ESP_ERR_INVALID_SIZE before reaching the modem.
    The report URL for demo.traccar.org with id gps-tracker-01 is about 155
    characters and fit the 160-byte buffer, but Sim800Modem::httpGet wraps it
    in AT+HTTPPARA="URL","..." in a buffer of the same size, which
    overflowed, so the request was rejected locally, three times, and the
    modem was power-cycled for nothing.
    The URL buffer (gsmUrlBytes, 256) is now sized from the Settings
    capacities with every numeric field at its widest, and the AT line buffer
    is that plus the wrapper. A host test builds the widest possible URL and
    checks it fits.
2026-10-10 Display: a failed init or a glitched bus no longer stops the tracker
    Ssd1306::begin aborted the firmware with ESP_ERROR_CHECK when the first
    transfer failed. On the bench an I2C hardware timeout during a modem
    burst hit exactly that line at boot and turned one reset into two. A
    display is not something a tracker should die for: begin now returns the
    error and the tracker runs without a screen, and the display task
    re-initialises the controller after five consecutive failed frames, since
    a bus glitch can leave the SSD1306 ignoring data until it is set up again.
2026-10-10 Health report: the uplink sends every diagnostics counter once a minute
    Positions alone say nothing while there is no fix and nothing about the
    card, the modem or the memory, so the web app could not tell which module
    is in trouble. The uplink task now sends a second request type built by
    HealthReport::buildUrl in the same one-GET shape as the OsmAnd position,
    marked health=1: tracker state, reset reason, uptime, sky view (used /
    tracked / in view, strongest C/N0, fix quality), every Diagnostics
    counter, card and modem state, battery, free and minimum heap, stack
    headroom per task and the firmware version. The first report goes out as
    soon as the bearer is up, before any fix, then every heal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
2026-10-10 Web app: live map, module health and analysis for the tracker (web/)
    A self-hosted replacement for Traccar that understands the tracker's
    health reports. One Node 22 / Fastify process receives the device's OsmAnd
    position GET and the health=1 GET on port 5055 and serves the React
    dashboard on the same port; Postgres 16 keeps the history (plain SQL, one
    migration, positions deduplicated on fix time so a re-sent record after a
    lost 200 is stored once).
    Dashboard: Google sign-in (ID token verified server-side, e-mail allow
    list, signed HttpOnly session cookie); device online/offline from the age
    of the last report, with the marker greyed, the trail faded and the value
    tiles dimmed when offline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
2026-10-10 Hardware notes: 5 V pin behaviour per board, star ground for the modem
    The devkit's 5VIN is input only (diode, ~1.7 V leakage on a meter); the
    SuperMini's 5V pin is VBUS itself and must never see the shield while USB
    is plugged in. Records the bench finding that the modem's transmit pulses
    through a shared breadboard rail corrupt every bus and reset the chip,
    and the wiring rule that avoids it.
2026-10-11 GNSS UART pins swapped: receiver TX to GPIO5, RX to GPIO4
    Straight wiring on the breadboard: the receiver's TX now lands on GPIO5
    and its RX on GPIO4, so the two jumpers no longer cross. Config, GPIO
    map, wiring diagram, assembly sheet and the KiCad schematic (ERC 0/0)
    are regenerated together so every drawing matches the firmware.
2026-10-11 Web app: notes and example config for running behind a Cloudflare Tunnel
    The SIM800C needs plain HTTP on a Cloudflare-proxied port, so the device
    URL is http://host with no port, Always Use HTTPS stays off for that
    hostname and Bot Fight Mode is off. cloudflared/config.yml.example has the
    ingress for a named tunnel to the app on 5055.
2026-10-11 Web app: Fly.io config with the HTTPS redirect off for the modem
    fly.toml deploys the existing Dockerfile with force_https = false so the
    SIM800C's plain GET on port 80 is answered, keeps one machine running for
    the device reports and the SSE streams, and health-checks /api/healthz.
    .dockerignore keeps node_modules, dist and .env out of the build context.
    README has the launch, secrets and verification steps.
2026-10-11 Web app: shared access key sign-in; production build fixes
    Sign-in is now one input: ACCESS_KEY, a long random string the owner hands
    to whoever may watch, or shares as https://host/#key=... (the fragment
    never reaches the server). The key is compared in constant time
    (AccessKeyGate, unit-tested), an address is locked out after ten wrong
    guesses in fifteen minutes, and the session cookie carries a fingerprint
    of the key so rotating ACCESS_KEY signs everyone out. Google sign-in stays
    as an optional second method for named accounts.
    Two bugs the first Fly deploy exposed, both reproduced with a local
    docker build: shared/types.ts compiled to CommonJS because the workspace
    root had no "type": "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
2026-10-11 Web app: show the real sign-in error; share links work on an open page
    A 401 from a sign-in call carried the server's message ('Wrong access
    key', 'Too many attempts') but the client treated every 401 as a lost
    session and printed 'sign in required'. The login page also now reacts to
    a #key= fragment arriving on an already open page, not only at load.
2026-10-11 Event log on the card and reset reason reported to the server
    The board resets on the bench during modem transmissions, and on
    battery there is no monitor to see what preceded it. EventLog hooks the
    ESP-IDF log output: every line still goes to the console and is also
    queued (copy only, never blocking the logging task); the logger task,
    the card's only writer, drains the queue into TRACKS/EVENTS.LOG in one
    append per batch. A full queue drops the newest line and counts it
    ('evt drop' in the diagnostics line); with no card the lines are
    discarded so the queue holds the newest ones for a later mount.
    The first report delivered after a boot carries '&reset=<reason>' in the
    OsmAnd query, so the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
2026-10-11 Web app: viewer key lives in the database, rotated from the dashboard
    The shared access key no longer needs a deploy to change. It is stored
    in a new settings table as an scrypt hash; ACCESS_KEY in the environment
    only seeds it on the first start. A second key, ADMIN_KEY, stays a server
    secret: signing in with it (same single login field) marks the session
    as admin and adds an "Access key" button that generates or sets a new
    viewer key and shows it once with a share link. Viewer sessions carry the
    fingerprint of the key generation they were issued for, so a rotation
    signs every viewer out within the 15 s cache window, while a viewer can
    never rotate the key and lock the owner out. Google and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
2026-10-11 Uplink: a request the server refuses backs off but never power-cycles the modem
    Traccar's demo server answered HTTP 400 to every report (the device id is
    not registered there), and three of those in a row made the firmware
    power-cycle the modem, as if the link were dead. The link was fine: the
    request had travelled DNS, TCP and HTTP to the server and back. A power
    cycle only forces a fresh network attach, the modem's heaviest transmit
    burst, for nothing.
    UplinkScheduler now separates the two outcomes: onFailure (no answer)
    counts toward the reset, onRejected (answered, not 200) only backs off.
    Both share the exponential wait so a server that refuses everything is
    still not hammered. The upl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
2026-10-11 Record only fixes worth recording: receiver accuracy mask and a quality gate
    A tracker sitting still at a window drew a 100 m zig-zag on the map. With
    few satellites and a poor geometry the position jumps tens of metres at a
    time, past the static hold's 20 m release, the motion detector reads the
    jumps as speed, and every jump is recorded and uploaded as a walk.
    Two layers now stop that. The receiver's output filter is set so that a
    fix whose own horizontal accuracy estimate is worse than 30 m is reported
    as invalid (CFG-NAVSPG-OUTFIL_PACC on the M10 as its own VALSET frame,
    pAcc with the posMask bit in CFG-NAV5 on the M8); the estimate includes
    signal quality and multipath, which HDOP alon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
2026-10-11 Uplink queue buffers outages, not every record: one sample per upload interval
    Moving, the policy produces a record a second and the modem delivers one
    every uplinkMinIntervalMs at best, so the gps task handing every record
    to the uplink queue filled it within a minute and dropped the oldest
    from then on: 157 'dropped' on the dashboard after a quiet hour, with a
    warning that could never clear.
    The card still gets every record; the uplink is offered one per
    uplinkMinIntervalMs (the same setting that paces the modem), so its
    queue of 64 holds about five minutes of outage and 'dropped' again means
    what the dashboard says it means: the link was down longer than that.
    The sampling interval follo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
2026-10-11 GNSS setup frames are checked against the receiver's ACK/NAK
    The configuration frames were sent blind, so a key the receiver's
    firmware does not know failed silently and the only evidence was the
    behaviour (a parked tracker still drifting). Every UBX configuration
    frame is answered with UBX-ACK-ACK or -NAK carrying the frame's class
    and id; UbxAckScanner finds that answer in the raw stream, NMEA text and
    all, on a ten-byte sliding window with the checksum verified. The
    receiver driver now waits up to 300 ms for each frame's answer and logs
    'rejected (NAK)' or 'no answer' per frame, and the boot line reports
    'n/m setup frames acknowledged'. Host tests cover ACK, NAK, a foreign
    frame and a cor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
2026-10-11 Hardware notes: resets follow the modem's registration burst; CFUN test
    Bisected on unchanged hardware: the last firmware that power-cycled the
    modem after server rejections resets 15 s after the modem comes back,
    during registration; the current firmware, which cycles the modem only
    after unanswered requests, runs for hours. Records that the registration
    burst is the case the wiring must survive, that 'at AT+CFUN=1,1' on the
    console reproduces it on demand, and the order of hardware steps if it
    still resets.
2026-10-11 Uplink: the modem's own 6xx HTTP statuses mean a lost bearer, not a rejection
    After a radio restart (AT+CFUN=1,1, or a network hiccup) the SIM800C
    answers every HTTPACTION with status 601, its own 'network error' code.
    The rejection rule from this morning took any non-zero status as a
    server answer, so the uplink backed off up to five minutes on a dead
    bearer and never reconnected.
    Statuses from 600 up are the modem's local error codes (600 not HTTP
    PDU, 601 network error, 602 no memory, 603 DNS, 604 stack busy); the
    transport now treats them as a lost bearer: it marks itself
    disconnected and the uplink task re-opens the bearer, a few seconds
    and no power cycle. Real server answers (2xx-5xx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
2026-10-11 Monitor sends a console line only on Enter
    Without send_on_enter the monitor forwards every keystroke as typed, so
    a log line arriving mid-command spliced the half-typed text with the
    next command ('AT+Cat AT+CFUN=1,1'). The line is now assembled locally
    and sent whole when Enter is pressed.
2026-10-11 Modem: wait for network registration before the GPRS attach; wiring test recorded
    After a cold boot the first AT+CGATT=1 was refused with ERROR every
    time because the network was still processing the registration; the
    bearer open failed, the uplink backed off 5 s and the retry succeeded.
    openBearer now polls AT+CREG? for up to 20 s and attaches only once the
    modem reports registered (home or roaming), so a cold boot costs no
    failed attempt and no warning lines.
    Hardware notes record the acceptance test for the wiring: three
    'at AT+CFUN=1,1' radio restarts and three 'at AT+CPOWD=1' cold boots,
    all survived on 2026-10-11 with the antenna attached, the modem on its
    own shield supply pair and t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
2026-10-11 Hardware notes: the battery shield dips its outputs when the charger is plugged or unplugged
    No power-path controller on the Battery Shield V8: the boost converter
    switches between charger input and cells, the outputs dip and the ESP32
    browns out. Recorded with the two workarounds (charger changes with the
    tracker off, or 1000 uF on the 5 V rail).
2026-10-11 Web app: the map no longer re-fits itself while you look at it
    The trail was refitted whenever the oldest point fell out of the time
    window, which with a report every 5 s meant every few seconds, undoing
    the user's zoom. The view is now fitted once per device and time range
    (plus once when the first points arrive), the in-range filtering runs
    once a minute instead of on every clock tick, and dragging the map turns
    Follow off so it stops panning to the newest point.
2026-10-11 Uplink: keep the queue short while the link is up, buffer only outages
    At the bench a 2G request takes 10-15 s and a health report takes one
    slot a minute, so the modem delivers 4-5 requests a minute while the gps
    task offered 12; the queue grew to 43 and the map showed positions ten
    minutes old. A live map wants the newest point, not every point late.
    While the transport is connected a record is offered to the uplink only
    if fewer than uplinkLiveBacklog (3) are already waiting; the card still
    gets every record. While the link is down the queue buffers the outage
    to its full depth as before, so 'dropped' keeps meaning an outage longer
    than the queue.
2026-10-11 README results: bench numbers, fault-injection outcome, charger hot-plug behaviour
    Fills the results section with what the diagnostics line and the
    dashboard showed on 2026-10-11: stack headroom, GNSS signal at a window,
    2G request time and delivered rate, the CFUN/CPOWD fault-injection
    results before and after the wiring change, and the charger hot-plug
    event with the self-recovery of the card and the display. The shield
    note records that pulling the charger reset the chip and plugging it in
    did not.
2026-10-12 BMA400 motion source: the accelerometer decides moving/parked
    The CJMCU-400 arrived, so the slot reserved for it is filled. Bma400
    (periph) probes 0x14 and 0x15 for the chip id, soft-resets, and
    configures generic interrupt 1 for activity: a change between
    consecutive samples above 96 mg on any axis, sustained for 10 samples at
    100 Hz, pulsed on INT1 (GPIO6). The ISR only counts pulses; no I2C
    traffic after begin(), so the bus stays the display's at run time.
    AccelMotionDetector (logic) implements IMotionDetector from an
    IActivitySource: moving on the first pulse, stopped after
    motion_stop_delay_ms without one. It needs no fix and is immune to the
    position noise that made the speed detector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
2026-10-12 BMA400: activity threshold 40 mg over 2 samples on the 100 Hz filter
    The first setting, 96 mg sustained for 10 consecutive samples, never
    fired: consecutive samples are 10 ms apart and a hand lifting the tracker
    changes acceleration by a few tens of mg per sample. Bosch's reference
    setting for this use (40 mg, two samples, acc_filt2) is now used; sensor
    noise of a few mg plus the 24 mg hysteresis keeps a parked tracker
    silent.
2026-10-12 Deep sleep while parked, woken by the BMA400 or the button
    SleepPolicy (logic, host-tested) decides when: Stationary for
    sleepAfterStationaryMs (10 min, 0 disables) with the uplink queue
    empty, so the last heartbeat is not lost. The gps task, owner of the
    FSM, then runs App::enterSleep: SleepRequested to the FSM (LED off), a
    final health report with state 'sleeping' so the dashboard sees a
    deliberate silence, modem to minimum functionality (AT+CFUN=0, ~2 mA; the
    next connect sends CFUN=1 and re-attaches without a cold-boot burst),
    GNSS to software backup mode via UBX-RXM-PMREQ (orbit data kept, woken
    by the first byte begin() now sends), display off, event log flushed and
    the card unmounted,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
2026-10-12 Screen shows local time (Kyiv, European summer-time rule); records keep UTC
    The clock on the tracking page was the receiver's UTC, three hours
    behind the wall clock in summer. Calendar (logic) now holds the date
    arithmetic that OsmAndProtocol used privately, plus the inverse and the
    last-Sunday rule; TimeZone applies a standard offset and, when enabled,
    the European summer time (01:00 UTC on the last Sunday of March to 01:00
    UTC on the last Sunday of October), which is Ukraine's rule. StatusView
    converts for the screen only: the CSV, the event log and the uploads
    stay in UTC so timestamps compare across zones. Two host tests pin the
    switch dates, the day rollover and the round trip.
2026-10-12 A tracker switched on while parked goes to STATIONARY on its first fix
    Motion sources report changes and start out 'not moving'. With the
    accelerometer in charge, a tracker that never moves since boot never
    emits Started, so never Stopped, and the FSM stayed in TRACKING at the
    moving log rate until the first move-and-stop. The epoch handler now
    keeps the FSM in step with the source: Tracking while the source says
    not moving is treated as MotionStopped.
2026-10-12 Sleep delay back to 10 min; 'diag' prints the CPU share per task
    The sleep cycle was verified on the bench with the 1 min value, so the
    intended 10 min is restored. The console 'diag' command now also prints
    FreeRTOS run-time statistics (CPU time per task and its share of the
    total), the figure the checklist's performance item asks for; the idle
    tasks' share is the headroom.
2026-10-12 Sleep sequence parks the other tasks first; modem waits stay under the watchdog
    The sleep sequence held the modem mutex through the final health report
    (up to ten seconds of HTTP) while the uplink task waited on that mutex
    with a 15 s timeout and no watchdog feed; five seconds in, the task
    watchdog reset the chip. The server's health rows showed it: every
    'sleeping' report was followed by a boot with rst=taskwdt, never
    deepsleep, so the tracker never actually slept.
    enterSleep now takes the modem, I2C and card mutexes in 1 s slices with
    the watchdog fed, then suspends the display, logger, uplink, ui and
    console tasks and removes them from the watchdog, and only then parks
    the hardware; the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
2026-10-13 GPIO ISR service installed once in App::begin
    Button and Bma400 each installed the shared service and tolerated the
    second call's ESP_ERR_INVALID_STATE, but the driver prints that as an
    error line on every boot. App::begin installs it once; the drivers only
    add their handlers.
2026-10-13 Deep sleep: hourly timer wake and RTC pulls kept powered
    Two hardening changes after the first real sleep on battery. A timer
    wakes the tracker once an hour, so a sleeping device sends a health
    report as a sign of life and no stuck wake source can leave it asleep
    for good; without motion it goes back to sleep after the usual parked
    period. The RTC peripheral domain is kept powered during deep sleep:
    ESP-IDF documents that the internal pull-ups and pull-downs the two
    GPIO wake sources rely on are lost otherwise. The boot line names the
    timer as a wake cause.
2026-10-13 Log lines carry wall-clock time; no sleep without the accelerometer; BMA400 probe retried
    Log timestamps now come from the system clock (HH:MM:SS.mmm), which the
    gps task sets from the first valid fix and which survives deep sleep,
    so the console and EVENTS.LOG show real time instead of milliseconds
    since boot. Before the first fix the clock reads from 00:00:00.
    The first battery sleep on 2026-10-13 never woke: the BMA400 had not
    answered at that boot, so no INT1 pulse could ever come, the button is
    not wired and that build had no timer wake. A boot without the
    accelerometer now runs with deep sleep disabled, since nothing could
    wake the tracker when it starts moving. The chip answered on o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
2026-10-13 Sleep delay back to 10 min; the modem capacitor and the sleep cycle recorded
    The one-minute bench value served its purpose: three park / sleep /
    motion-wake cycles on battery with reset reason deepsleep and no
    watchdog resets. Hardware notes record that the 1000 uF across the
    modem's VSS and GND is what ended the battery-only resets, that this
    shield keeps its output up at the sleeping load, and that the BMA400's
    CS pin must be tied to 3.3 V; the README results carry the numbers.
2026-10-13 Watchdog names the task it caught; SD commands capped at 1 s; 1 min sleep for the demo
    First walk outdoors (2026-10-13, two hours on battery): nine resets, all
    TASK WATCHDOG, all while moving and within a minute of a boot, none at the
    bench. No power resets, so the modem supply fix holds. The watchdog's own
    message about which task missed the deadline goes to the USB console only,
    which nobody reads in the field.
    - TaskWatchdog: esp_task_wdt_isr_user_handler() (weak in ESP-IDF) collects
    the names from esp_task_wdt_print_triggered_tasks() into an RTC_NOINIT
    record with a magic word; TaskWatchdog::takeLastCulprits() reads it
    once at the next boot. App::begin logs "Task watchdog was trip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
2026-10-13 Event log lines on the card carry the date
    EVENTS.LOG spans days of runs, and a line with only a time of day no
    longer says which one. ESP-IDF can print "YY-MM-DD HH:MM:SS.sss" itself,
    but only with log v2, which calls the vprintf hook three times per line
    (prefix, body, newline) and would need the hook rewritten to reassemble
    lines; not worth the risk a week before the defence.
    Instead EventLog::stampDate inserts "YY-MM-DD " after the "I (" of every
    formatted line before it is queued, giving the same layout as ESP-IDF's
    full timestamp on the card: "I (26-10-13 13:48:01.000) tracker: ...".
    UTC, from the clock the gps task sets; 70-01-01 before the first fix
    after a power-up. The console kee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
2026-10-13 One repository, four folders: firmware, hardware, web, docs
    The project is handed in as one public repository, so the tree now says
    what runs where:
    - firmware/ the PlatformIO / ESP-IDF project (include, src, test,
    platformio.ini, sdkconfig.defaults) with its own README on
    how to build, flash and test, and where each class lives.
    - hardware/ components, power tree and GPIO map (README.md, formerly
    docs/HARDWARE.md), the KiCad schematic, the wiring diagram
    and the assembly sheet. The generators in tools/ write here.
    - web/ the server and the map, as merged from branch tracker-web.
    - docs/ architecture and the presentation plan.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
2026-10-13 Project documents speak only about the project; wiring diagram renders on its own
    The README, the architecture and hardware notes, the build config and the
    code comments no longer refer to the course this tracker was built for:
    the design rules are stated where they apply instead of by reference, and
    the two course-only documents (the requirements mapping and the defence
    plan) leave the repository.
    hardware/wiring.svg was drawn for the assembly sheet, whose CSS supplies
    the colours and fonts through variables; on its own, as the README shows
    it on GitHub, every var(--fg) fell back to black on a transparent
    background. The generator's --standalone flag now adds a default theme and
    a white pa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
2026-10-13 C1 1000 µF at the modem in every drawing; sequence diagrams for the three main flows
    The 1000 µF electrolytic across the BIGGA board's VSS and GND pins ended
    the resets on battery (hardware/README.md §5, README results), but the
    component table, the power tree, the schematic, the wiring diagram and
    the assembly sheet still said "no external capacitor". All five now carry
    C1: a Device:C_Polarized on the +5V net next to J2 in the schematic (ERC
    still 0/0), an electrolytic symbol across the modem's supply wires in the
    wiring diagram, a row in the module table and a word in the assembly step.
    docs/ARCHITECTURE.md §2 gains three Mermaid sequence diagrams: a fix
    becoming a record on the card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
2026-10-13 Wiring diagram: wider modules, subtitles that fit, BMA400 CS and SDO ties drawn
    The module boxes were 200 px wide and several subtitles and notes ran past
    their borders. The canvas grows to 1320 x 840, the module columns to
    250 px, the devkit and the channels shift with them, and a subtitle may
    wrap onto a second line (the MicroSD and BMA400 boxes). Every text now
    sits inside its box.
    The accelerometer's CS pin tied to 3.3 V, which fixed the chip starting
    in SPI mode on one power-up in three, had not reached the drawings: the
    wiring diagram, the schematic (J6 is now an 8-pin header, ERC 0/0) and the
    assembly sheet show CS to 3V3 and SDO to GND (optional, fixes the address
    at 0x14). The hard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
2026-10-13 Wiring diagram: the switch label clear of the subtitle, the BMA400 note inside its box
2026-10-13 Button press reaches the display even when its queue is busy; system page fits the panel
    A short press posted NextPage to the display queue the same way fixes and
    counters are posted: best effort, dropped when the eight slots are taken.
    While tracking the queue is busy, so presses were lost and the page only
    changed after several tries. The press now goes to the front of the queue
    and waits up to 200 ms for a slot (Config::buttonPostWaitMs); a loss is
    logged instead of silent.
    The system page drew six 10 px lines under a 16 px title on a 64 px panel:
    the HDOP line started at y=60 and was cut, and the sky line was drawn at
    y=56 over it. The title is now one text size and the six lines sit 9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
2026-10-13 Button: read the settled pin level after an edge instead of the level the ISR saw
    The GPIO interrupt stored the pin level at the moment the handler ran.
    During contact bounce that level can belong to a later bounce than the
    edge that raised the interrupt, so the last edge of a release could read
    "still pressed". ButtonDecoder then waited for a release that never
    came, treated the next press as a repeated level, and reported its
    release as one long press. On the bench that showed as a page switch
    that needed two or three presses.
    The edge now only wakes the ui task. It waits buttonSettleMs (20 ms),
    drains the edges the bounce produced meanwhile, and feeds the decoder
    the level the pin actual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
2026-10-13 Button: every decoded press is logged; the diagnostics line counts the edges the ISR saw
    With a press that sometimes does nothing, the log said nothing either.
    Now a short or long press writes one line, and the diagnostics line
    shows btn edges N drop M: edges at zero after a press means the pin
    never moved (a wiring fault), edges without a press line means the
    levels or the decoder.
2026-10-13 Button: accept a level only after it has held for 50 ms
    The bench switch produced 16 edges per press and kept bouncing past the
    20 ms settle wait, so the level read after it was sometimes mid-bounce:
    a release read as still pressed, the next press as a repeat, and its
    release as a long press. The ui task now samples the pin every 5 ms and
    feeds the decoder only a level that has held for 50 ms, giving up after
    300 ms. Edges that arrive while sampling are drained; the ones the
    8-slot queue cannot take during a burst are harmless and still counted.
2026-10-13 README results: CPU load from the run-time statistics, button after the bounce fix
2026-10-13 Button: a tap released before the level settles still counts as a short press
    With the 50 ms stability window a quick tap could end before "pressed"
    had held long enough: the settled level was "released", the decoder saw
    no change, and one press in a few did nothing. The sampling loop now
    also counts how long it saw the pin pressed; a complete tap of at least
    10 ms inside the window, starting from the released state, is reported
    as a short press.
2026-10-13 Button: one press, one event; the contacts' trailing bounce is ignored
    After a release the contacts kept bouncing past the sampling window, and
    a late edge was handled as a new event: a bounce dip of 10 ms passed the
    tap rule and toggled the page straight back, so every second or third
    press seemed to do nothing. The button logic now lives in
    App::readButton(): sample until the level is stable, decode, then give
    the contacts 150 ms (buttonLockoutMs) and discard whatever edges they
    produced. A tap must be seen pressed for 30 ms, not 10, to count.
2026-10-13 Button: the module 2.6 debounce; a press counts when confirmed, not at the release
    ButtonDecoder is now the four-state sampled debounce from the homework
    (released, confirming a press, pressed, confirming a release): the ui
    task samples the pin every 5 ms while the button is active and a level
    counts once it has held for 50 ms. The press is reported as soon as it is
    confirmed, so the page switches at once and a bouncing release can never
    be taken for a second press, which is what toggled the page straight
    back before. Holding for a second reports Long once while held. The GPIO
    interrupt only wakes the ui task; the level it saw mid-bounce is not
    used. Three host tests cover the confirmed pres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
2026-10-13 Status LED on GPIO48 for the DevKitC: the onboard WS2812 never lit on GPIO38
    The devkit build drove the status LED on GPIO38, the pin of the DevKitC-1
    v1.1, and it never lit on the board in use. The LED answers on GPIO48,
    where v1.0 boards and most clones have it, so that is the default now;
    the comment and the pin table say which boards use GPIO38 instead.
2026-10-13 Wake pads handed to the RTC controller before sleep; 'hang' console command tests the watchdog
    Before deep sleep the two wake pads (BMA400 INT1, button) are switched to
    the RTC controller with their pulls first, given 20 ms to settle, and
    their levels logged ('Wake lines: button high (idle), INT1 low (idle)')
    before the wake levels are armed. A line read at the wrong level at that
    moment woke the chip 0.4 s after every sleep, reported as a button press.
    The console gains 'hang': the console task stops feeding the task
    watchdog, so the reset, the panic printout and the culprit record can be
    checked on the bench. Verified: 'Task watchdog was tripped by: console'
    on the next boot, rst=taskwdt: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
2026-10-13 FreezeTrace: tick-hook sampler and tick-storm guard
    A hang that leaves only the tick interrupt running leaves no trace: the
    task watchdog's own interrupt cannot run, and its 10 s hardware backstop
    resets the chip without a word (TG0WDT_SYS_RST, no panic, no culprit).
    Seen on the bench and on the walk.
    FreezeTrace runs inside the tick interrupt on both cores, from IRAM, and
    every 250 ticks records the interrupted program counter, the running
    task, the interrupt-enable mask, the flash-cache state, both systimer
    counters, the tick alarm period and its interrupt flag into RTC memory.
    After a watchdog reset the next boot prints the last samples.
    The samples showed the hang: the ESP-IDF systimer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
2026-10-13 Revert "FreezeTrace: tick-hook sampler and tick-storm guard"
    This reverts commit 9383225dc9948ec2d8d8d0d721f20cfebb0c268f.
2026-10-13 Console 'hang' command removed; the watchdog culprit path is verified
    The bench reboots turned out to be the SIM800C's transmit bursts reaching
    the ESP32-S3 through the supply or the antenna: with the modem's 5 V
    wire pulled the board ran clean. The watchdog test command served its
    purpose once ('Task watchdog was tripped by: console' on the next boot)
    and is not a field feature, so it goes; the tick-hook sampler went in
    the previous revert for the same reason.
2026-10-13 Sleep no longer waits for ever on a stuck uplink: a 3 min grace period, then sleep with the backlog on the card
    A parked tracker slept only once the uplink queue was empty, so that the
    last points and the sleeping report were not lost. Without coverage the
    queue never drains, and the tracker stayed awake until the battery was
    flat, for points that were already on the card.
    SleepPolicy takes a second parameter, uplinkGraceMs: past
    sleepAfterStationaryMs it still waits for an empty queue, but only that
    much longer (Config::Defaults::sleepUplinkGraceMs, 3 min), then sleeps
    anyway. The sleep entry logs how many points were left waiting; the
    health report already carries the backlog. New host te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
2026-10-13 Sleep entry: screen off first, 10 s for a modem that never attached; a button line that reads pressed at rest is left out of the wake sources
    The sleep sequence took the modem mutex first and waited up to 60 s for
    it; with the modem unpowered the uplink task holds that mutex through
    its power-on retries, so the screen stayed on for a minute or more
    after 'Parked' and sleep looked broken. Now the I2C and SD owners are
    stopped and the display turned off within a second, and the modem wait
    is 60 s only when an upload is in flight, 10 s when the uplink never
    connected.
    armWakeSources() reads the button line after the RTC pulls have
    settled. A line at the pressed level would end the sleep the mo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
2026-10-13 Button: the 3-pin module with its own pull-down (signal idles low, press to 3.3 V)
    The bench button is a module with VCC, GND and a signal pin and a
    pull-down resistor on its board. Wired to GPIO2 with the firmware set
    for a bare switch, the line read low at rest, presses were seen the
    wrong way round, and every deep sleep ended at once as a button wake.
    Config::buttonPressedHigh = true: short and long presses verified.
2026-10-14 SuperMini as the default build environment on this branch
    A plain 'pio run -t upload' built and flashed the DevKitC image onto the
    SuperMini: 8 MB in the image header against the module's 4 MB, so the
    second-stage bootloader stopped at the flash probe, and the console sat
    on GPIO43/44, which the SuperMini needs for the modem. On this branch
    the default environment is supermini, so the bare commands do the right
    thing; the devkitc environment is still there with -e devkitc.
2026-10-14 Modem PWRKEY tied to GND on the SuperMini build; GPIO7 left unconnected
    On the SuperMini the tracker reset with a task watchdog about 17 s after
    'Modem answered', during every network attach, while the modem itself
    ran fine on its own supply and the SuperMini ignored its antenna held
    right beside it. With the PWRKEY wire moved from GPIO7 to GND, the same
    setup ran through two attaches and minutes of uploads without a reset:
    the GPIO7 wire, which runs from beside the modem's power circuit into an
    ESP32 pad, carried the disturbance into the chip.
    Config::gsmPowerKeyWired = false: the modem powers itself and stays on,
    the driver configures no key pin and sends no pulses ('waiting for it to
    boo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
2026-10-14 PWRKEY back on GPIO7 through an RC filter; a fix with an implausible date is not a fix
    PWRKEY: with 1 kΩ in series and 100 nF to GND at the SuperMini end, the
    modem was switched on by the key, attached from scratch (no reused
    bearer) and the tracker ran for over six minutes, through a full sleep
    cycle, without the task-watchdog resets the bare wire caused during every
    attach. gsmPowerKeyWired is true again; the pin table documents the
    filter and the PWRKEY-to-GND alternative.
    Clock: after a cold start the Foxeer receiver reported a valid fix dated
    2087-07-15 with five satellites, and that date set the system clock and
    stamped the log until the next boot. Calendar::plausible() bounds the
    da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
2026-10-14 Drawings and documents for the SuperMini build: PWRKEY RC filter, 3-pin button module
    Wiring diagram (tools/gen_wiring_svg.py, hardware/wiring.svg): the
    SuperMini in the middle with the modem UART on GPIO43/44, R5 1k and C2
    100n in the PWRKEY wire, the 3-pin button module on 3V3/GND/GPIO2, and
    notes for the board's 5V pin (USB VBUS, shield only with USB unplugged)
    and the DevKitC's GPIO17/18.
    KiCad schematic (tools/gen_schematic.py, hardware/kicad/): U1 is the
    SuperMini on TXD0/RXD0, PWRKEY_GPIO -> R5 -> GSM_PWRKEY with C2 to GND,
    J7 the button module in place of SW1, 3V3_BOARD for the board's LDO.
    ERC clean; PDF and SVG re-exported.
    Assembly sheet: the new diagram embedded, warnings for t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
2026-10-15 Modem PWRKEY driven through an NPN transistor; drawings and documents follow
    GPIO7 now drives the base of a 2N2222A through 10 kΩ, with 100 kΩ from
    base to GND to keep it off while the ESP boots or sleeps; the emitter is
    on GND and the collector pulls the modem's PWRKEY down. SIMCom's hardware
    guide recommends this drive: nothing from the modem's line, neither the
    attach bursts nor its ~4 V pull-up, reaches the ESP32 pin. Verified on
    the bench with the modem powered off first: key pulse, 'Modem answered',
    a fresh GPRS attach, no resets.
    Config::gsmPowerKeyViaTransistor (true) inverts the drive: push-pull,
    idle low, high for the 1.2 s pulse. false keeps the open-drain drive for
    the RC-filt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
2026-10-17 Modem after a deep-sleep wake: talk to it instead of pressing PWRKEY; retry a refused GPRS attach
    Field test 2026-10-17 (SuperMini, 2 h 43 min): after each of the 23
    wakes the modem was silent to the 6 s baud-rate probe, the firmware
    pressed PWRKEY twice and GPRS came back 32-84 s later (median 37 s).
    The modem had only been parked with AT+CFUN=0, so the first press
    switched a running modem off and the second switched it on again.
    App::begin now tells the modem driver after a deep-sleep wake that the
    modem was left running (Sim800Modem::expectRunning). powerOn() then
    probes at the fixed 115200 baud for up to Config::gsmWakeProbeWindowMs
    (10 s), each try preceded by a bare CR, before falling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
